Akshay1595/Lithium-ion_battery_as_service/Docs/Bills/Bill_30.jpeg

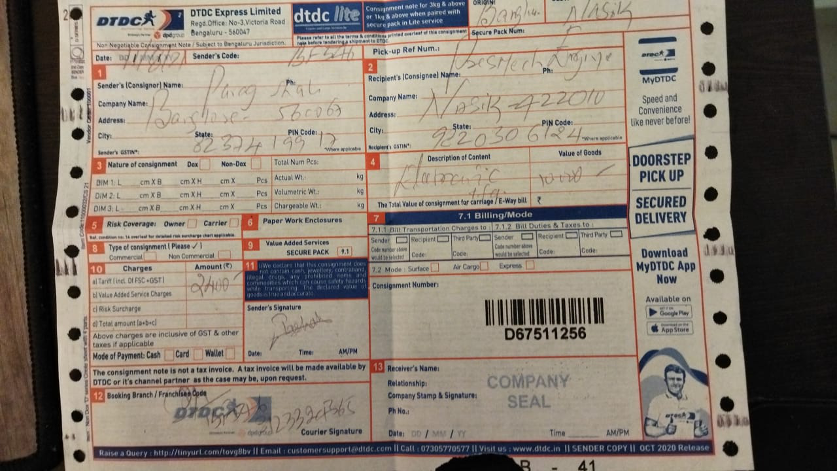
Docs/Bills/Bill_30.jpeg
