Akshay1595/Lithium-ion_battery_as_service/Docs/Technical docs/LiBaaS Embedded System Block Diagram.pptx

## LiBaaS Embedded System Block Diagram

Date: 09-12-2020

## Embedded System

Embedded System

LCD

Battery pack

CAN
Tranceiver

BMS

uC Development board

Contactor

Contactor
Control

Keypad

Power Supply

Power Jack

## Wiring diagram V1.0

Keep open wire

Re+

Re-

Relay

Keep open wire

BMS

CANH

CANL

Battery pack

Fuse

Connectors

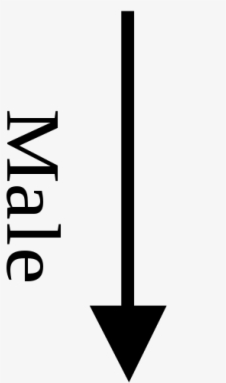
[picture p13: figure]
Female Connector Symbol - Free Transparent PNG Download - PNGkey
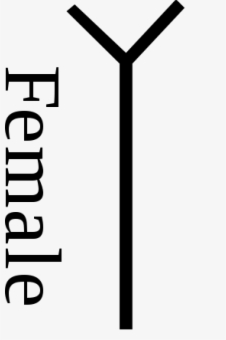
[picture p14: figure]
Female Connector Symbol - Free Transparent PNG Download - PNGkey

Charger

Keep open wire

Keep open wire

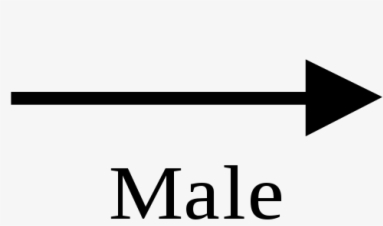
[picture p15: figure]
Female Connector Symbol - Free Transparent PNG Download - PNGkey
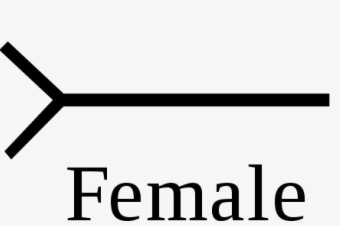
[picture p16: figure]
Female Connector Symbol - Free Transparent PNG Download - PNGkey

## Slide 4
