Akshay1595/Lithium-ion_battery_as_service/Docs/Technical docs/LiBaaS Embedded System_Load Box for batterypack.pptx

## LiBaaS Embedded System Load

Date: 08-03-2021

## Load Diagram

12V 1A

12V 1A

12V 1A

12V 1A

Battery
pack

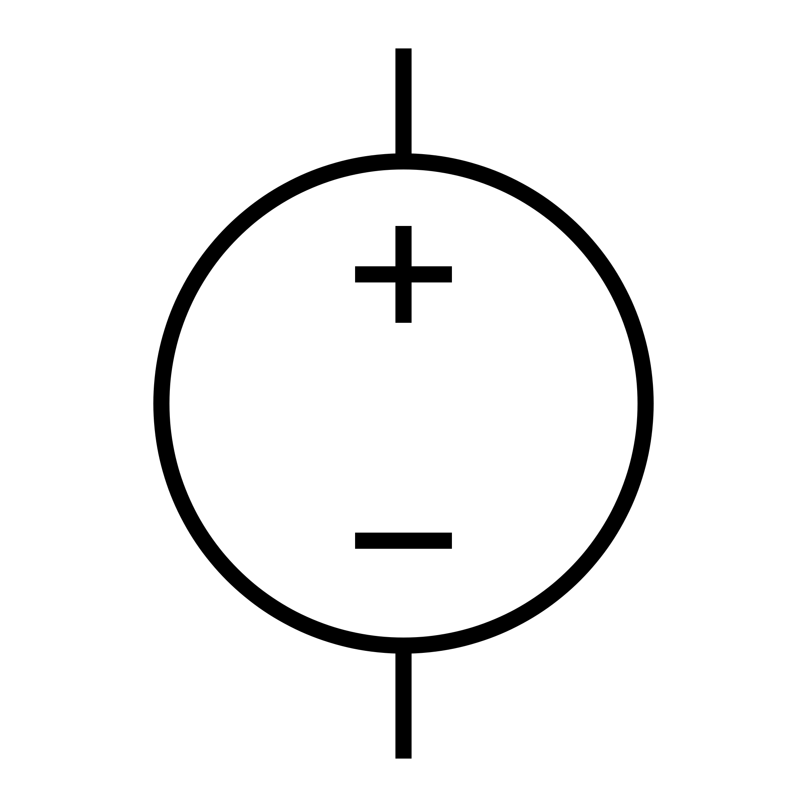
[picture p17: figure]
