Akshay1595/Lithium-ion_battery_as_service/Docs/Bills/Bill_18.PDF

PackageID: 1Z5674320407168464 ShipmentID: 5674324MTJ3

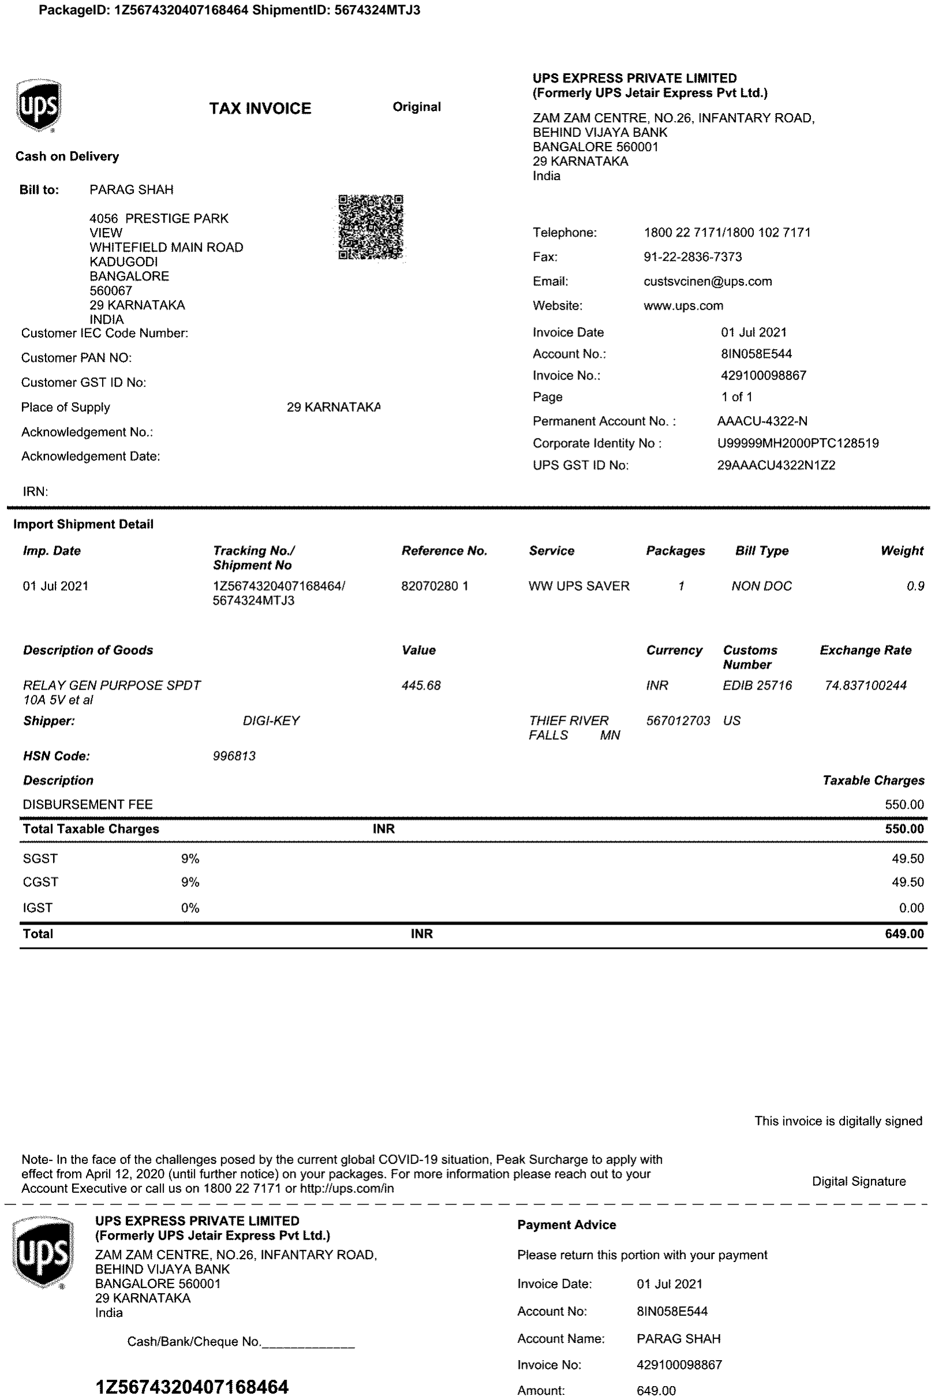
[picture p27: page 3]
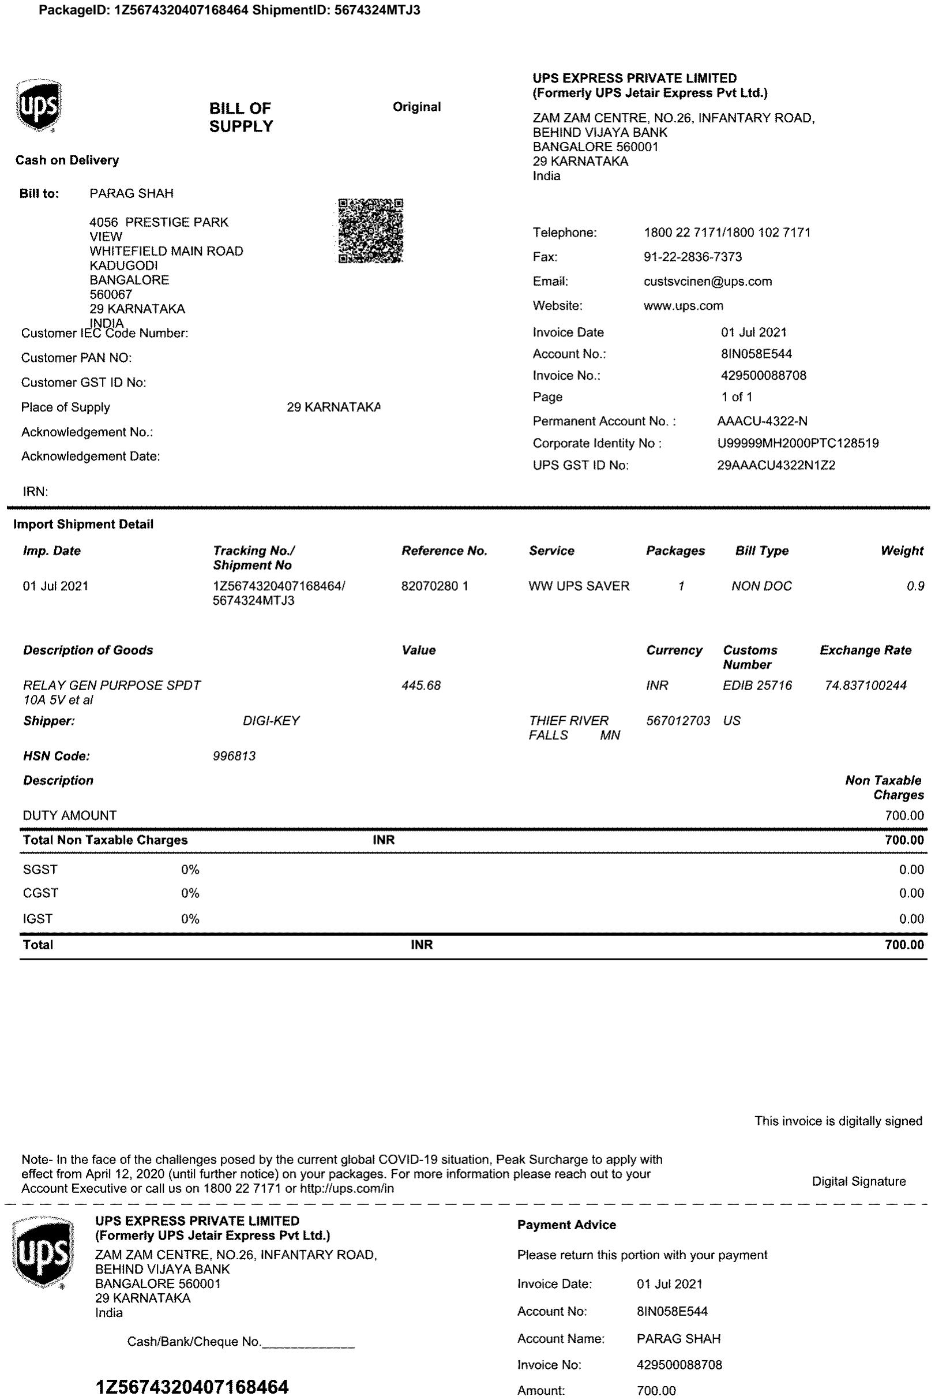
[picture p28: page 4]
