Akshay1595/Lithium-ion_battery_as_service/HW_design/Libaas_System/LibaaS calculations.xlsx

Vin | 53 | V
Vout | 15 | V
Vdrop | 38 | V
Iload | 0.05 | A
Pd (BJT) | 1.9 | W
R6 | 5 | OHM
Pd (R6) | 0.0125 | W
IZ | 0.005 | A
Vz | 15 | V
R8 | 7600 | OHM
Pd (R8) | 0.19 | W
