Akshay1595/Lithium-ion_battery_as_service/Docs/Bills/Bill_13.PNG

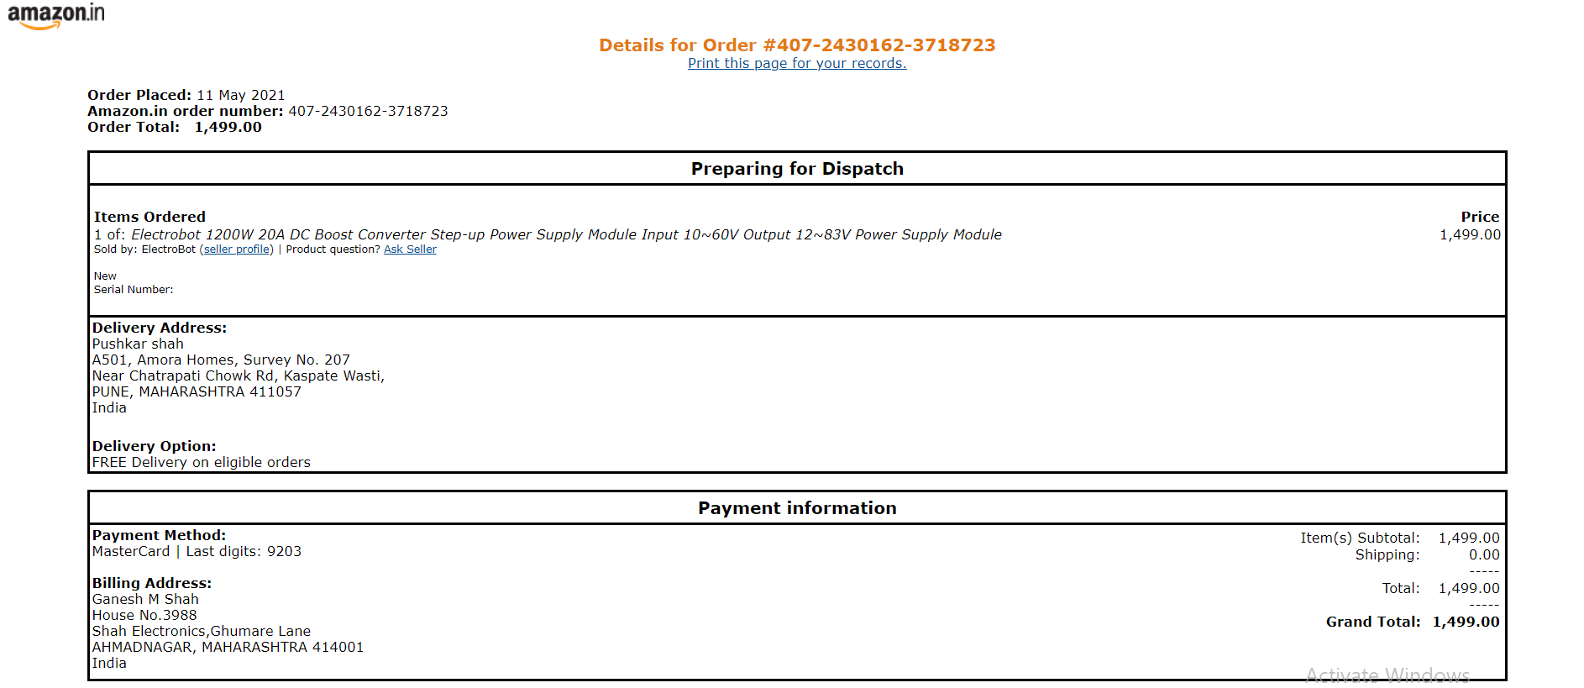
Docs/Bills/Bill_13.PNG
