Akshay1595/Lithium-ion_battery_as_service/Docs/Bills/Bill_27.jpeg

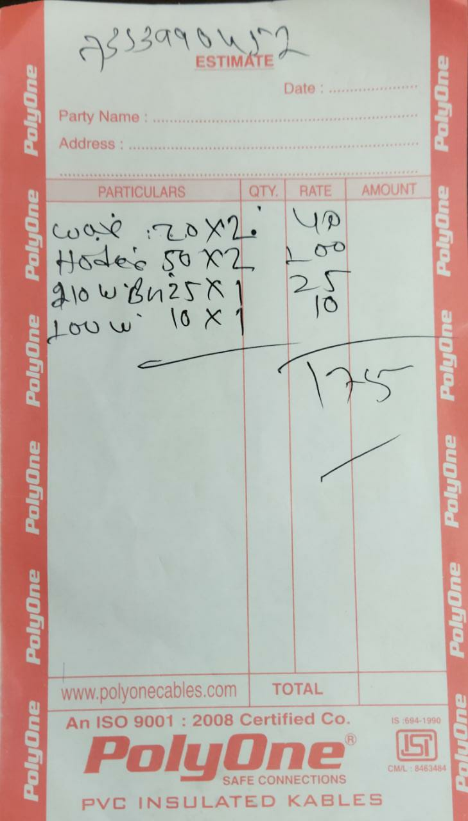
Docs/Bills/Bill_27.jpeg
