Akshay1595/Lithium-ion_battery_as_service/Docs/Bills/Bill_32.JPG

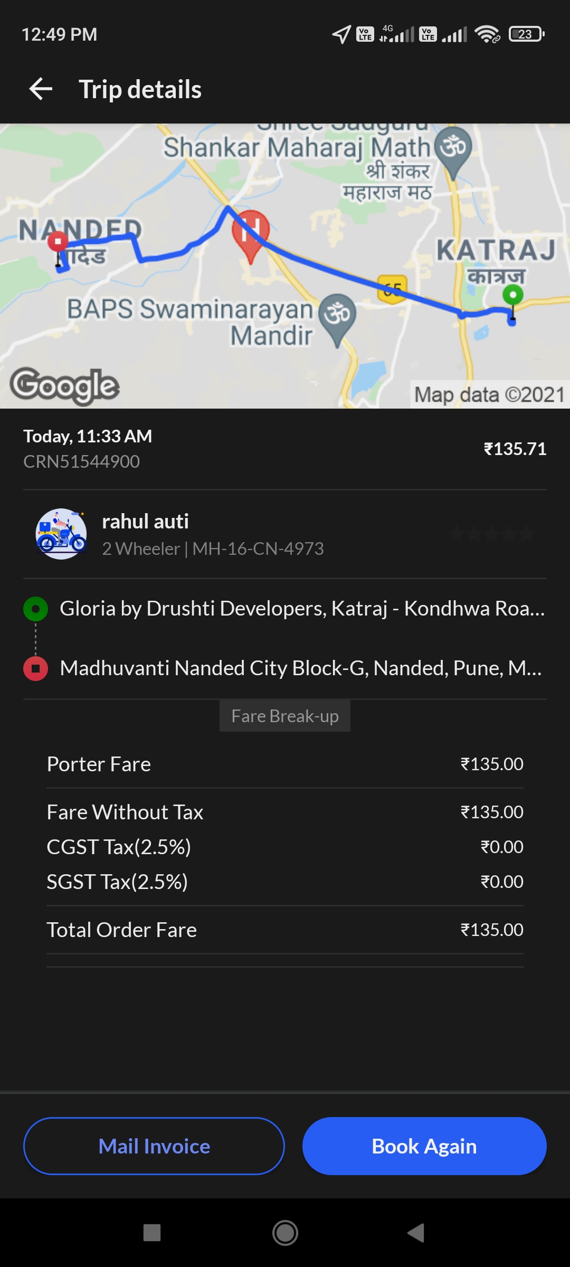
Docs/Bills/Bill_32.JPG
