Akshay1595/Lithium-ion_battery_as_service/Docs/Bills/Bill_33.jpeg

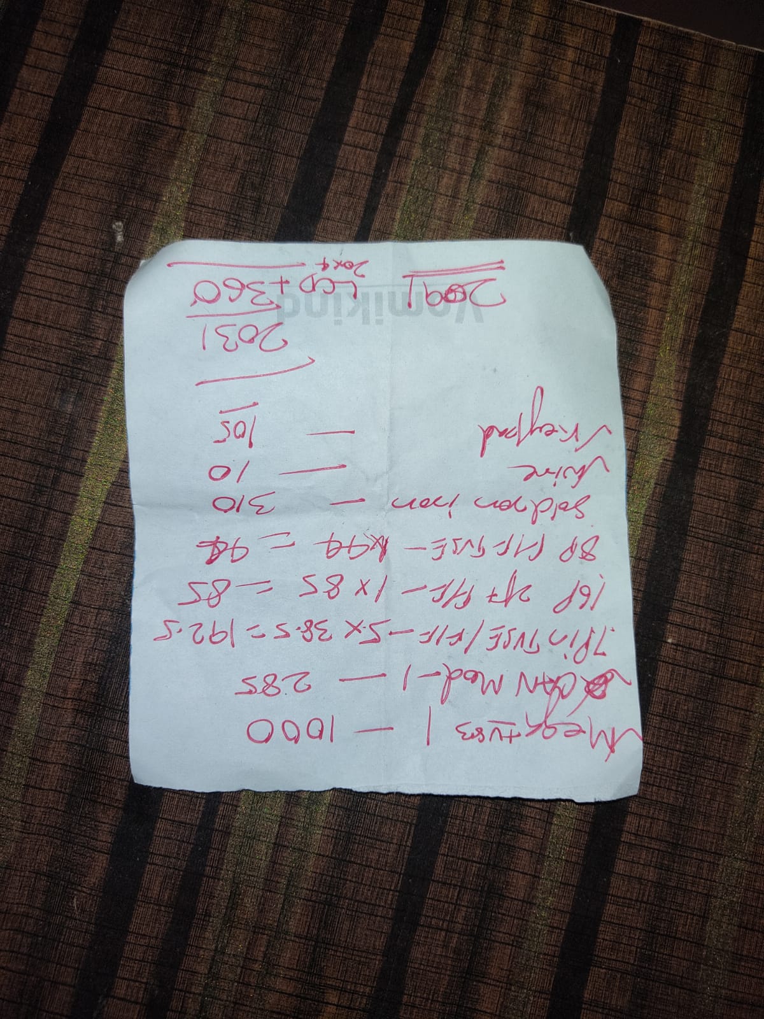
Docs/Bills/Bill_33.jpeg
