Akshay1595/Lithium-ion_battery_as_service/Docs/FlowChart.png

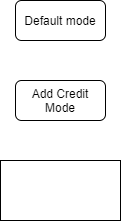
Docs/FlowChart.png
