Akshay1595/Lithium-ion_battery_as_service/Docs/megapins.png

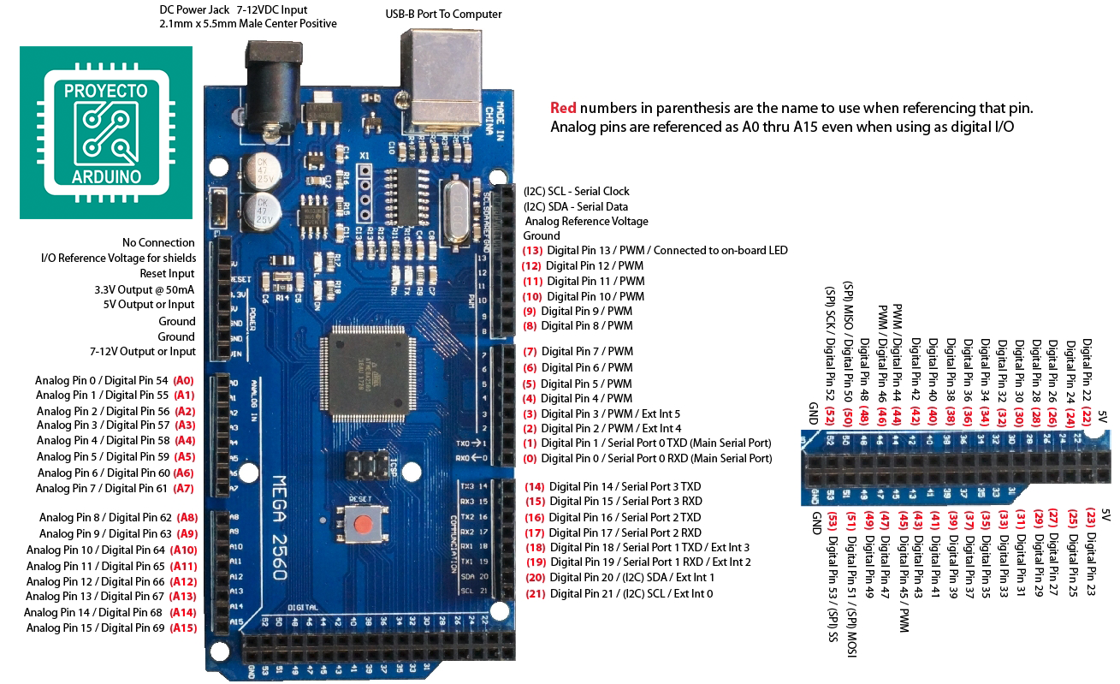
Docs/megapins.png
