Akshay1595/Lithium-ion_battery_as_service/HW_design/Libaas_System/LiBaaS_component assy check.xlsx

Sheet: BOARD1
DESIGNATOR | DESC | Part no. | Footprint | STATUS
C1 | CAP CER 1uF 25V 10% X7R 0805 |  | CAP0805 | OKAY
C2 | CAP CER 0.1uF 50V 5% X7R 0805, CAP CER 0.1uF 100V 10% X7R 0805 |  | CAP0805 | OKAY
C3 | CAP ALUM 47uF 63V 20% SMD |  | CAPAE-D10_H1050 | MOUNTED WRONG | OKAY
C4 | CAP CER 0.1uF 50V 5% X7R 0805, CAP CER 0.1uF 100V 10% X7R 0805 |  | CAP0805 | OKAY
C5 | CAP CER 0.1uF 50V 5% X7R 0805, CAP CER 0.1uF 100V 10% X7R 0805 |  | CAP0805 | OKAY
C6 | Aluminium Electrolytic Capacitors - Radial Leaded 470uF 10 Volts 20% |  | UVZ1A471MED | OKAY
C7 | CAP CER 0.1uF 50V 5% X7R 0805, CAP CER 0.1uF 100V 10% X7R 0805 |  | CAP0805 | OKAY
C8 | CAP CER 0.1uF 50V 5% X7R 0805, CAP CER 0.1uF 100V 10% X7R 0805 |  | CAP0805 | OKAY
C9 | CAP CER 0.1uF 50V 5% X7R 0805, CAP CER 0.1uF 100V 10% X7R 0805 |  | CAP0805 | OKAY
C10 | CAP CER 1uF 25V 10% X7R 0805 |  | CAP0805 | OKAY
C11 | CAP CER 1uF 25V 10% X7R 0805 |  | CAP0805 | OKAY
C12 | CAP CER 0.1uF 50V 5% X7R 0805, CAP CER 0.1uF 100V 10% X7R 0805 |  | CAP0805 | OKAY
C13 | CAP CER 0.1uF 50V 5% X7R 0805, CAP CER 0.1uF 100V 10% X7R 0805 |  | CAP0805 | OKAY
C14 | CAP CER 1uF 25V 10% X7R 0805 |  | CAP0805 | OKAY
C15 | CAP CER 0.1uF 50V 5% X7R 0805, CAP CER 0.1uF 100V 10% X7R 0805 |  | CAP0805 | OKAY
C16 | CAP CER 1uF 25V 10% X7R 0805 |  | CAP0805 | OKAY
D1 | DIODE GEN 1000V 1A DO214AC | S1M | DO-214AC | OKAY
D2 | LED YELLOW CLEAR 0805 |  | LED0805 | NOT OKAY
D3 | Zener Diodes 7.5V 500mW SOD123 | MMSZ5236B-7-F | SOD-123 | MOUNTED WRONG | OKAY
D4 | Zener Diode 36V 225mW Â±6% Surface Mount SOT-23-3 (TO-236) | BZX84C36-7 | SOT23 | REMOVE | OKAY
D5 | DIODE SCHOTTKY 60V 1A MICROSMP | B140HW-7-F | SOD123 | OKAY
D6 | TH Zener diode_36V |  | DO-41 | TO BE MOUNTED | OKAY
D7 | DIODE GEN 75V 150mA SOD-323 | 1N4148WSQ-7-F | SOD-323 | OKAY
D8 | DIODE GEN 75V 150mA SOD-323 | 1N4148WSQ-7-F | SOD-323 | OKAY
D9 | LED BLUE CLEAR 0805 |  | LED0805 | MOUNTED WRONG | OKAY
D10 | LED RED CLEAR 0805 |  | LED0805 | MOUNTED WRONG | OKAY
D11 | LED WHITE CLEAR 0805 |  | LED0805 | MOUNTED WRONG | no
D12 | LED GREEN CLEAR 0805 |  | LED0805 | MOUNTED WRONG | OKAY
D13 | LED RED CLEAR 0805 |  | LED0805 | MOUNTED WRONG | OKAY
D14 | Zener Diodes 15V 590mW SOD123 | BZT52-B15X | SOD-123 | OKAY
J1, J2 | PHOENIX CONNECTOR 5.08mm PITCH |  |  | OKAY
L1 | 100uH 1.05A 20% SMD Power Inductors; shielded | SDS125-101M-LF |  | OKAY
Q1 | BJT NPN 100V 3A TO-252 | MJD31CT4-A | TO-252 | OKAY
Q2 | BJT NPN 25V 3A SOT-223 | BCP56 | SOT-223 | OKAY
Q3 | FET N-CH 60V 380mA SOT23 | 2N7002KQ-7 | SOT-23 | OKAY
R1 | RES THK FLM 10Ohm 1% 1/2W 2512 |  | RES2512 | OKAY
R2 | RES THK FLM 0Ohm 1% 1/4W 1206 |  | RES1206 | OKAY
R3 | RES THK FLM 0Ohm 1% 1/4W 1206 |  | RES1206 | OKAY
R4 | RES THK FLM 2.2kOhm 1% 1/10W 0603 |  | RES0603 | OKAY
R5 | RES THK FLM 182Ohm 1% 1/10W 0603 |  | RES0603 | OKAY
R6 | RES THK FLM 10Ohm 1% 1/2W 2512 |  | RES2512 | OKAY
R7 | RES THK FLM 0Ohm 1% 1/4W 1206 |  | RES1206 | OKAY
R8 | RES THK FLM 2.2kOhm 1% 1/10W 0603 |  | RES0603 | OKAY
R9 | RES THK FLM 2.2kOhm 1% 1/10W 0603 |  | RES0603 | OKAY
R10 | RES THK FLM 47kOhm 1% 1/10W 0603 |  | RES0603 | OKAY
R11 | RES THK FLM 182Ohm 1% 1/10W 0603 |  | RES0603 | OKAY
R12 | RES THK FLM 182Ohm 1% 1/10W 0603 |  | RES0603 | OKAY
R13 | RES THK FLM 182Ohm 1% 1/10W 0603 |  | RES0603 | OKAY
R14 | RES THK FLM 182Ohm 1% 1/10W 0603 |  | RES0603 | OKAY
R15 | Through Hole Trimmer Potentiometer_10K |  | Trim_pot_3296 | OKAY
R16 | RES THK FLM 182Ohm 1% 1/10W 0603 |  | RES0603 | OKAY
R17 | RES THK FLM 182Ohm 1% 1/10W 0603 |  | RES0603 | OKAY
SW1 | SW TACT SPST-NO 32V 10mA GULLWING |  | KSC243GLFG | OKAY
U1 | Switching Voltage Regulators 3A Step-Down SMPS Regulator |  | LM2596-5.0 | OKAY
U2 | Arduino Mega |  | Berg strips | OKAY

Sheet: BOARD2
DESIGNATOR | DESC | Part no. | Footprint | STATUS
C1 | CAP CER 1uF 25V 10% X7R 0805 |  | CAP0805 | OKAY
C2 | CAP CER 0.1uF 50V 5% X7R 0805, CAP CER 0.1uF 100V 10% X7R 0805 |  | CAP0805 | OKAY
C3 | CAP ALUM 47uF 63V 20% SMD |  | CAPAE-D10_H1050 | MOUNTED WRONG | OKAY
C4 | CAP CER 0.1uF 50V 5% X7R 0805, CAP CER 0.1uF 100V 10% X7R 0805 |  | CAP0805 | OKAY
C5 | CAP CER 0.1uF 50V 5% X7R 0805, CAP CER 0.1uF 100V 10% X7R 0805 |  | CAP0805 | OKAY
C6 | Aluminium Electrolytic Capacitors - Radial Leaded 470uF 10 Volts 20% |  | UVZ1A471MED | TO BE MOUNTED | OKAY
C7 | CAP CER 0.1uF 50V 5% X7R 0805, CAP CER 0.1uF 100V 10% X7R 0805 |  | CAP0805 | OKAY
C8 | CAP CER 0.1uF 50V 5% X7R 0805, CAP CER 0.1uF 100V 10% X7R 0805 |  | CAP0805 | OKAY
C9 | CAP CER 0.1uF 50V 5% X7R 0805, CAP CER 0.1uF 100V 10% X7R 0805 |  | CAP0805 | OKAY
C10 | CAP CER 1uF 25V 10% X7R 0805 |  | CAP0805 | OKAY
C11 | CAP CER 1uF 25V 10% X7R 0805 |  | CAP0805 | OKAY
C12 | CAP CER 0.1uF 50V 5% X7R 0805, CAP CER 0.1uF 100V 10% X7R 0805 |  | CAP0805 | OKAY
C13 | CAP CER 0.1uF 50V 5% X7R 0805, CAP CER 0.1uF 100V 10% X7R 0805 |  | CAP0805 | OKAY
C14 | CAP CER 1uF 25V 10% X7R 0805 |  | CAP0805 | OKAY
C15 | CAP CER 0.1uF 50V 5% X7R 0805, CAP CER 0.1uF 100V 10% X7R 0805 |  | CAP0805 | OKAY
C16 | CAP CER 1uF 25V 10% X7R 0805 |  | CAP0805 | OKAY
D1 | DIODE GEN 1000V 1A DO214AC | S1M | DO-214AC | OKAY
D2 | LED YELLOW CLEAR 0805 |  | LED0805 | NOT OKAY
D3 | Zener Diodes 7.5V 500mW SOD123 | MMSZ5236B-7-F | SOD-123 | MOUNTED WRONG | OKAY
D4 | Zener Diode 36V 225mW Â±6% Surface Mount SOT-23-3 (TO-236) | BZX84C36-7 | SOT23 | REMOVE | OKAY
D5 | DIODE SCHOTTKY 60V 1A MICROSMP | B140HW-7-F | SOD123 | OKAY
D6 | TH Zener diode_36V |  | DO-41 | TO BE MOUNTED | OKAY
D7 | DIODE GEN 75V 150mA SOD-323 | 1N4148WSQ-7-F | SOD-323 | OKAY
D8 | DIODE GEN 75V 150mA SOD-323 | 1N4148WSQ-7-F | SOD-323 | OKAY
D9 | LED BLUE CLEAR 0805 |  | LED0805 | MOUNTED WRONG | OKAY
D10 | LED RED CLEAR 0805 |  | LED0805 | MOUNTED WRONG | OKAY
D11 | LED WHITE CLEAR 0805 |  | LED0805 | MOUNTED WRONG | OKAY
D12 | LED GREEN CLEAR 0805 |  | LED0805 | MOUNTED WRONG | OKAY
D13 | LED RED CLEAR 0805 |  | LED0805 | MOUNTED WRONG | OKAY
D14 | Zener Diodes 15V 590mW SOD123 | BZT52-B15X | SOD-123 | TO BE MOUNTED | OKAY
J1, J2 | PHOENIX CONNECTOR 5.08mm PITCH |  |  | OKAY
L1 | 100uH 1.05A 20% SMD Power Inductors; shielded | SDS125-101M-LF |  | TO BE MOUNTED | OKAY
Q1 | BJT NPN 100V 3A TO-252 | MJD31CT4-A | TO-252 | OKAY
Q2 | BJT NPN 25V 3A SOT-223 | BCP56 | SOT-223 | OKAY
Q3 | FET N-CH 60V 380mA SOT23 | 2N7002KQ-7 | SOT-23 | OKAY
R1 | RES THK FLM 10Ohm 1% 1/2W 2512 |  | RES2512 | ADJUST IN THE PITCH | OKAY
R2 | RES THK FLM 0Ohm 1% 1/4W 1206 |  | RES1206 | OKAY
R3 | RES THK FLM 0Ohm 1% 1/4W 1206 |  | RES1206 | OKAY
R4 | RES THK FLM 2.2kOhm 1% 1/10W 0603 |  | RES0603 | TO BE MOUNTED | OKAY
R5 | RES THK FLM 182Ohm 1% 1/10W 0603 |  | RES0603 | OKAY
R6 | RES THK FLM 10Ohm 1% 1/2W 2512 |  | RES2512 | OKAY
R7 | RES THK FLM 0Ohm 1% 1/4W 1206 |  | RES1206 | OKAY
R8 | RES THK FLM 2.2kOhm 1% 1/10W 0603 |  | RES0603 | TO BE MOUNTED | OKAY
R9 | RES THK FLM 2.2kOhm 1% 1/10W 0603 |  | RES0603 | OKAY
R10 | RES THK FLM 47kOhm 1% 1/10W 0603 |  | RES0603 | OKAY
R11 | RES THK FLM 182Ohm 1% 1/10W 0603 |  | RES0603 | OKAY
R12 | RES THK FLM 182Ohm 1% 1/10W 0603 |  | RES0603 | OKAY
R13 | RES THK FLM 182Ohm 1% 1/10W 0603 |  | RES0603 | OKAY
R14 | RES THK FLM 182Ohm 1% 1/10W 0603 |  | RES0603 | OKAY
R15 | Through Hole Trimmer Potentiometer_10K |  | Trim_pot_3296 | OKAY
R16 | RES THK FLM 182Ohm 1% 1/10W 0603 |  | RES0603 | OKAY
R17 | RES THK FLM 182Ohm 1% 1/10W 0603 |  | RES0603 | OKAY
SW1 | SW TACT SPST-NO 32V 10mA GULLWING |  | KSC243GLFG | OKAY
U1 | Switching Voltage Regulators 3A Step-Down SMPS Regulator |  | LM2596-5.0 | OKAY
U2 | Arduino Mega |  | Berg strips | TO BE MOUNTED | OKAY
DS1 |  |  | Berg strips | TO BE MOUNTED | OKAY
P2 |  |  | Berg strips | TO BE MOUNTED | OKAY

Sheet: BOARD3
DESIGNATOR | DESC | Part no. | Footprint | STATUS
C1 | CAP CER 1uF 25V 10% X7R 0805 |  | CAP0805 | OKAY
C2 | CAP CER 0.1uF 50V 5% X7R 0805, CAP CER 0.1uF 100V 10% X7R 0805 |  | CAP0805 | OKAY
C3 | CAP ALUM 47uF 63V 20% SMD |  | CAPAE-D10_H1050 | MOUNTED WRONG | OKAY
C4 | CAP CER 0.1uF 50V 5% X7R 0805, CAP CER 0.1uF 100V 10% X7R 0805 |  | CAP0805 | OKAY
C5 | CAP CER 0.1uF 50V 5% X7R 0805, CAP CER 0.1uF 100V 10% X7R 0805 |  | CAP0805 | OKAY
C6 | Aluminium Electrolytic Capacitors - Radial Leaded 470uF 10 Volts 20% |  | UVZ1A471MED | TO BE MOUNTED | OKAY
C7 | CAP CER 0.1uF 50V 5% X7R 0805, CAP CER 0.1uF 100V 10% X7R 0805 |  | CAP0805 | OKAY
C8 | CAP CER 0.1uF 50V 5% X7R 0805, CAP CER 0.1uF 100V 10% X7R 0805 |  | CAP0805 | OKAY
C9 | CAP CER 0.1uF 50V 5% X7R 0805, CAP CER 0.1uF 100V 10% X7R 0805 |  | CAP0805 | OKAY
C10 | CAP CER 1uF 25V 10% X7R 0805 |  | CAP0805 | OKAY
C11 | CAP CER 1uF 25V 10% X7R 0805 |  | CAP0805 | OKAY
C12 | CAP CER 0.1uF 50V 5% X7R 0805, CAP CER 0.1uF 100V 10% X7R 0805 |  | CAP0805 | OKAY
C13 | CAP CER 0.1uF 50V 5% X7R 0805, CAP CER 0.1uF 100V 10% X7R 0805 |  | CAP0805 | OKAY
C14 | CAP CER 1uF 25V 10% X7R 0805 |  | CAP0805 | OKAY
C15 | CAP CER 0.1uF 50V 5% X7R 0805, CAP CER 0.1uF 100V 10% X7R 0805 |  | CAP0805 | OKAY
C16 | CAP CER 1uF 25V 10% X7R 0805 |  | CAP0805 | OKAY
D1 | DIODE GEN 1000V 1A DO214AC | S1M | DO-214AC | OKAY
D2 | LED YELLOW CLEAR 0805 |  | LED0805 | NOT OKAY
D3 | Zener Diodes 7.5V 500mW SOD123 | MMSZ5236B-7-F | SOD-123 | MOUNTED WRONG | OKAY
D4 | Zener Diode 36V 225mW Â±6% Surface Mount SOT-23-3 (TO-236) | BZX84C36-7 | SOT23 | REMOVE | OKAY
D5 | DIODE SCHOTTKY 60V 1A MICROSMP | B140HW-7-F | SOD123 | OKAY
D6 | TH Zener diode_36V |  | DO-41 | TO BE MOUNTED | OKAY
D7 | DIODE GEN 75V 150mA SOD-323 | 1N4148WSQ-7-F | SOD-323 | OKAY
D8 | DIODE GEN 75V 150mA SOD-323 | 1N4148WSQ-7-F | SOD-323 | OKAY
D9 | LED BLUE CLEAR 0805 |  | LED0805 | MOUNTED WRONG | OKAY
D10 | LED RED CLEAR 0805 |  | LED0805 | MOUNTED WRONG | OKAY
D11 | LED WHITE CLEAR 0805 |  | LED0805 | MOUNTED WRONG | OKAY
D12 | LED GREEN CLEAR 0805 |  | LED0805 | MOUNTED WRONG | OKAY
D13 | LED RED CLEAR 0805 |  | LED0805 | MOUNTED WRONG | OKAY
D14 | Zener Diodes 15V 590mW SOD123 | BZT52-B15X | SOD-123 | TO BE MOUNTED | OKAY
J1, J2 | PHOENIX CONNECTOR 5.08mm PITCH |  |  | OKAY
L1 | 100uH 1.05A 20% SMD Power Inductors; shielded | SDS125-101M-LF |  | TO BE MOUNTED | OKAY
Q1 | BJT NPN 100V 3A TO-252 | MJD31CT4-A | TO-252 | OKAY
Q2 | BJT NPN 25V 3A SOT-223 | BCP56 | SOT-223 | OKAY
Q3 | FET N-CH 60V 380mA SOT23 | 2N7002KQ-7 | SOT-23 | OKAY
R1 | RES THK FLM 10Ohm 1% 1/2W 2512 |  | RES2512 | ADJUST IN THE PITCH | OKAY
R2 | RES THK FLM 0Ohm 1% 1/4W 1206 |  | RES1206 | OKAY
R3 | RES THK FLM 0Ohm 1% 1/4W 1206 |  | RES1206 | OKAY
R4 | RES THK FLM 2.2kOhm 1% 1/10W 0603 |  | RES0603 | TO BE MOUNTED | OKAY
R5 | RES THK FLM 182Ohm 1% 1/10W 0603 |  | RES0603 | OKAY
R6 | RES THK FLM 10Ohm 1% 1/2W 2512 |  | RES2512 | OKAY
R7 | RES THK FLM 0Ohm 1% 1/4W 1206 |  | RES1206 | OKAY
R8 | RES THK FLM 2.2kOhm 1% 1/10W 0603 |  | RES0603 | TO BE MOUNTED | OKAY
R9 | RES THK FLM 2.2kOhm 1% 1/10W 0603 |  | RES0603 | OKAY
R10 | RES THK FLM 47kOhm 1% 1/10W 0603 |  | RES0603 | OKAY
R11 | RES THK FLM 182Ohm 1% 1/10W 0603 |  | RES0603 | OKAY
R12 | RES THK FLM 182Ohm 1% 1/10W 0603 |  | RES0603 | OKAY
R13 | RES THK FLM 182Ohm 1% 1/10W 0603 |  | RES0603 | OKAY
R14 | RES THK FLM 182Ohm 1% 1/10W 0603 |  | RES0603 | OKAY
R15 | Through Hole Trimmer Potentiometer_10K |  | Trim_pot_3296 | OKAY
R16 | RES THK FLM 182Ohm 1% 1/10W 0603 |  | RES0603 | OKAY
R17 | RES THK FLM 182Ohm 1% 1/10W 0603 |  | RES0603 | OKAY
SW1 | SW TACT SPST-NO 32V 10mA GULLWING |  | KSC243GLFG | OKAY
U1 | Switching Voltage Regulators 3A Step-Down SMPS Regulator |  | LM2596-5.0 | OKAY
U2 | Arduino Mega |  | Berg strips | OKAY

Sheet: BOARD4
DESIGNATOR | DESC | Part no. | Footprint | STATUS
C1 | CAP CER 1uF 25V 10% X7R 0805 |  | CAP0805 | OKAY
C2 | CAP CER 0.1uF 50V 5% X7R 0805, CAP CER 0.1uF 100V 10% X7R 0805 |  | CAP0805 | OKAY
C3 | CAP ALUM 47uF 63V 20% SMD |  | CAPAE-D10_H1050 | MOUNTED WRONG | OKAY
C4 | CAP CER 0.1uF 50V 5% X7R 0805, CAP CER 0.1uF 100V 10% X7R 0805 |  | CAP0805 | OKAY
C5 | CAP CER 0.1uF 50V 5% X7R 0805, CAP CER 0.1uF 100V 10% X7R 0805 |  | CAP0805 | OKAY
C6 | Aluminium Electrolytic Capacitors - Radial Leaded 470uF 10 Volts 20% |  | UVZ1A471MED | TO BE MOUNTED | OKAY
C7 | CAP CER 0.1uF 50V 5% X7R 0805, CAP CER 0.1uF 100V 10% X7R 0805 |  | CAP0805 | OKAY
C8 | CAP CER 0.1uF 50V 5% X7R 0805, CAP CER 0.1uF 100V 10% X7R 0805 |  | CAP0805 | OKAY
C9 | CAP CER 0.1uF 50V 5% X7R 0805, CAP CER 0.1uF 100V 10% X7R 0805 |  | CAP0805 | OKAY
C10 | CAP CER 1uF 25V 10% X7R 0805 |  | CAP0805 | OKAY
C11 | CAP CER 1uF 25V 10% X7R 0805 |  | CAP0805 | OKAY
C12 | CAP CER 0.1uF 50V 5% X7R 0805, CAP CER 0.1uF 100V 10% X7R 0805 |  | CAP0805 | OKAY
C13 | CAP CER 0.1uF 50V 5% X7R 0805, CAP CER 0.1uF 100V 10% X7R 0805 |  | CAP0805 | OKAY
C14 | CAP CER 1uF 25V 10% X7R 0805 |  | CAP0805 | OKAY
C15 | CAP CER 0.1uF 50V 5% X7R 0805, CAP CER 0.1uF 100V 10% X7R 0805 |  | CAP0805 | OKAY
C16 | CAP CER 1uF 25V 10% X7R 0805 |  | CAP0805 | OKAY
D1 | DIODE GEN 1000V 1A DO214AC | S1M | DO-214AC | OKAY
D2 | LED YELLOW CLEAR 0805 |  | LED0805 | NOT OKAY
D3 | Zener Diodes 7.5V 500mW SOD123 | MMSZ5236B-7-F | SOD-123 | MOUNTED WRONG | OKAY
D4 | Zener Diode 36V 225mW Â±6% Surface Mount SOT-23-3 (TO-236) | BZX84C36-7 | SOT23 | REMOVE | OKAY
D5 | DIODE SCHOTTKY 60V 1A MICROSMP | B140HW-7-F | SOD123 | OKAY
D6 | TH Zener diode_36V |  | DO-41 | TO BE MOUNTED | OKAY
D7 | DIODE GEN 75V 150mA SOD-323 | 1N4148WSQ-7-F | SOD-323 | OKAY
D8 | DIODE GEN 75V 150mA SOD-323 | 1N4148WSQ-7-F | SOD-323 | OKAY
D9 | LED BLUE CLEAR 0805 |  | LED0805 | MOUNTED WRONG | OKAY
D10 | LED RED CLEAR 0805 |  | LED0805 | MOUNTED WRONG | OKAY
D11 | LED WHITE CLEAR 0805 |  | LED0805 | MOUNTED WRONG | OKAY
D12 | LED GREEN CLEAR 0805 |  | LED0805 | MOUNTED WRONG | OKAY
D13 | LED RED CLEAR 0805 |  | LED0805 | MOUNTED WRONG | OKAY
D14 | Zener Diodes 15V 590mW SOD123 | BZT52-B15X | SOD-123 | TO BE MOUNTED | OKAY
J1, J2 | PHOENIX CONNECTOR 5.08mm PITCH |  |  | OKAY
L1 | 100uH 1.05A 20% SMD Power Inductors; shielded | SDS125-101M-LF |  | TO BE MOUNTED | OKAY
Q1 | BJT NPN 100V 3A TO-252 | MJD31CT4-A | TO-252 | OKAY
Q2 | BJT NPN 25V 3A SOT-223 | BCP56 | SOT-223 | OKAY
Q3 | FET N-CH 60V 380mA SOT23 | 2N7002KQ-7 | SOT-23 | OKAY
R1 | RES THK FLM 10Ohm 1% 1/2W 2512 |  | RES2512 | ADJUST IN THE PITCH | OKAY
R2 | RES THK FLM 0Ohm 1% 1/4W 1206 |  | RES1206 | OKAY
R3 | RES THK FLM 0Ohm 1% 1/4W 1206 |  | RES1206 | OKAY
R4 | RES THK FLM 2.2kOhm 1% 1/10W 0603 |  | RES0603 | TO BE MOUNTED | OKAY
R5 | RES THK FLM 182Ohm 1% 1/10W 0603 |  | RES0603 | OKAY
R6 | RES THK FLM 10Ohm 1% 1/2W 2512 |  | RES2512 | OKAY
R7 | RES THK FLM 0Ohm 1% 1/4W 1206 |  | RES1206 | OKAY
R8 | RES THK FLM 2.2kOhm 1% 1/10W 0603 |  | RES0603 | TO BE MOUNTED | OKAY
R9 | RES THK FLM 2.2kOhm 1% 1/10W 0603 |  | RES0603 | OKAY
R10 | RES THK FLM 47kOhm 1% 1/10W 0603 |  | RES0603 | OKAY
R11 | RES THK FLM 182Ohm 1% 1/10W 0603 |  | RES0603 | OKAY
R12 | RES THK FLM 182Ohm 1% 1/10W 0603 |  | RES0603 | OKAY
R13 | RES THK FLM 182Ohm 1% 1/10W 0603 |  | RES0603 | OKAY
R14 | RES THK FLM 182Ohm 1% 1/10W 0603 |  | RES0603 | OKAY
R15 | Through Hole Trimmer Potentiometer_10K |  | Trim_pot_3296 | OKAY
R16 | RES THK FLM 182Ohm 1% 1/10W 0603 |  | RES0603 | OKAY
R17 | RES THK FLM 182Ohm 1% 1/10W 0603 |  | RES0603 | OKAY
SW1 | SW TACT SPST-NO 32V 10mA GULLWING |  | KSC243GLFG | OKAY
U1 | Switching Voltage Regulators 3A Step-Down SMPS Regulator |  | LM2596-5.0 | OKAY
U2 | Arduino Mega |  | Berg strips | TO BE MOUNTED | ok

Sheet: BOARD5
DESIGNATOR | DESC | Part no. | Footprint | STATUS
C1 | CAP CER 1uF 25V 10% X7R 0805 |  | CAP0805 | OKAY
C2 | CAP CER 0.1uF 50V 5% X7R 0805, CAP CER 0.1uF 100V 10% X7R 0805 |  | CAP0805 | OKAY
C3 | CAP ALUM 47uF 63V 20% SMD |  | CAPAE-D10_H1050 | MOUNTED WRONG | OKAY
C4 | CAP CER 0.1uF 50V 5% X7R 0805, CAP CER 0.1uF 100V 10% X7R 0805 |  | CAP0805 | OKAY
C5 | CAP CER 0.1uF 50V 5% X7R 0805, CAP CER 0.1uF 100V 10% X7R 0805 |  | CAP0805 | OKAY
C6 | Aluminium Electrolytic Capacitors - Radial Leaded 470uF 10 Volts 20% |  | UVZ1A471MED | TO BE MOUNTED | OKAY
C7 | CAP CER 0.1uF 50V 5% X7R 0805, CAP CER 0.1uF 100V 10% X7R 0805 |  | CAP0805 | OKAY
C8 | CAP CER 0.1uF 50V 5% X7R 0805, CAP CER 0.1uF 100V 10% X7R 0805 |  | CAP0805 | OKAY
C9 | CAP CER 0.1uF 50V 5% X7R 0805, CAP CER 0.1uF 100V 10% X7R 0805 |  | CAP0805 | OKAY
C10 | CAP CER 1uF 25V 10% X7R 0805 |  | CAP0805 | OKAY
C11 | CAP CER 1uF 25V 10% X7R 0805 |  | CAP0805 | OKAY
C12 | CAP CER 0.1uF 50V 5% X7R 0805, CAP CER 0.1uF 100V 10% X7R 0805 |  | CAP0805 | OKAY
C13 | CAP CER 0.1uF 50V 5% X7R 0805, CAP CER 0.1uF 100V 10% X7R 0805 |  | CAP0805 | OKAY
C14 | CAP CER 1uF 25V 10% X7R 0805 |  | CAP0805 | OKAY
C15 | CAP CER 0.1uF 50V 5% X7R 0805, CAP CER 0.1uF 100V 10% X7R 0805 |  | CAP0805 | OKAY
C16 | CAP CER 1uF 25V 10% X7R 0805 |  | CAP0805 | OKAY
D1 | DIODE GEN 1000V 1A DO214AC | S1M | DO-214AC | OKAY
D2 | LED YELLOW CLEAR 0805 |  | LED0805 | NOT OKAY | OKAY
D3 | Zener Diodes 7.5V 500mW SOD123 | MMSZ5236B-7-F | SOD-123 | MOUNTED WRONG | OKAY
D4 | Zener Diode 36V 225mW Â±6% Surface Mount SOT-23-3 (TO-236) | BZX84C36-7 | SOT23 | REMOVE | OKAY
D5 | DIODE SCHOTTKY 60V 1A MICROSMP | B140HW-7-F | SOD123 | OKAY
D6 | TH Zener diode_36V |  | DO-41 | TO BE MOUNTED | OKAY
D7 | DIODE GEN 75V 150mA SOD-323 | 1N4148WSQ-7-F | SOD-323 | OKAY
D8 | DIODE GEN 75V 150mA SOD-323 | 1N4148WSQ-7-F | SOD-323 | OKAY
D9 | LED BLUE CLEAR 0805 |  | LED0805 | MOUNTED WRONG | OKAY
D10 | LED RED CLEAR 0805 |  | LED0805 | MOUNTED WRONG | OKAY
D11 | LED WHITE CLEAR 0805 |  | LED0805 | MOUNTED WRONG | OKAY
D12 | LED GREEN CLEAR 0805 |  | LED0805 | MOUNTED WRONG | OKAY
D13 | LED RED CLEAR 0805 |  | LED0805 | MOUNTED WRONG | MOUNTED WRONG
D14 | Zener Diodes 15V 590mW SOD123 | BZT52-B15X | SOD-123 | TO BE MOUNTED | OKAY
J1, J2 | PHOENIX CONNECTOR 5.08mm PITCH |  |  | OKAY
L1 | 100uH 1.05A 20% SMD Power Inductors; shielded | SDS125-101M-LF |  | TO BE MOUNTED | OKAY
Q1 | BJT NPN 100V 3A TO-252 | MJD31CT4-A | TO-252 | OKAY
Q2 | BJT NPN 25V 3A SOT-223 | BCP56 | SOT-223 | OKAY
Q3 | FET N-CH 60V 380mA SOT23 | 2N7002KQ-7 | SOT-23 | OKAY
R1 | RES THK FLM 10Ohm 1% 1/2W 2512 |  | RES2512 | ADJUST IN THE PITCH | to be mounted again
R2 | RES THK FLM 0Ohm 1% 1/4W 1206 |  | RES1206 | OKAY
R3 | RES THK FLM 0Ohm 1% 1/4W 1206 |  | RES1206 | OKAY
R4 | RES THK FLM 2.2kOhm 1% 1/10W 0603 |  | RES0603 | TO BE MOUNTED | OKAY
R5 | RES THK FLM 182Ohm 1% 1/10W 0603 |  | RES0603 | OKAY
R6 | RES THK FLM 10Ohm 1% 1/2W 2512 |  | RES2512 | OKAY
R7 | RES THK FLM 0Ohm 1% 1/4W 1206 |  | RES1206 | OKAY
R8 | RES THK FLM 2.2kOhm 1% 1/10W 0603 |  | RES0603 | TO BE MOUNTED | OKAY
R9 | RES THK FLM 2.2kOhm 1% 1/10W 0603 |  | RES0603 | OKAY
R10 | RES THK FLM 47kOhm 1% 1/10W 0603 |  | RES0603 | OKAY
R11 | RES THK FLM 182Ohm 1% 1/10W 0603 |  | RES0603 | OKAY
R12 | RES THK FLM 182Ohm 1% 1/10W 0603 |  | RES0603 | OKAY
R13 | RES THK FLM 182Ohm 1% 1/10W 0603 |  | RES0603 | OKAY
R14 | RES THK FLM 182Ohm 1% 1/10W 0603 |  | RES0603 | OKAY
R15 | Through Hole Trimmer Potentiometer_10K |  | Trim_pot_3296 | OKAY
R16 | RES THK FLM 182Ohm 1% 1/10W 0603 |  | RES0603 | OKAY
R17 | RES THK FLM 182Ohm 1% 1/10W 0603 |  | RES0603 | OKAY
SW1 | SW TACT SPST-NO 32V 10mA GULLWING |  | KSC243GLFG | OKAY
U1 | Switching Voltage Regulators 3A Step-Down SMPS Regulator |  | LM2596-5.0 | OKAY
U2 | Arduino Mega |  | Berg strips | TO BE MOUNTED | OKAY
DS1 |  |  | Berg strips | TO BE MOUNTED | OKAY
