Akshay1595/Lithium-ion_battery_as_service/HW_design/Libaas_System/Libaas_System_090221.xlsx

Description | Designator | Footprint | Part number | Quantity
CAP CER 1uF 25V 10% X7R 0805 | C1, C10, C11, C14, C16 | CAP0805 | C0805C105K3RACAUTO | 5
CAP CER 0.1uF 50V 5% X7R 0805, CAP CER 0.1uF 100V 10% X7R 0805 | C2, C4, C5, C7, C8, C9, C12, C13, C15 | CAP0805 | C0805C104J5RACAUTO, C0805C104K1RACAUTO | 9
CAP ALUM 47uF 63V 20% SMD | C3 | CAPAE-D10_H1050 | EEE-TG1J470P | 1
Aluminium Electrolytic Capacitors - Radial Leaded 470uF 10 Volts 20% | C6 | UVZ1A471MED | UVZ1A471MED | 1
DIODE GEN 1000V 1A DO214AC | D1 | DO-214AC | S1M | 1
LED YELLOW CLEAR 0805 | D2 | LED0805 | LTST-C171CKT | 1
Zener Diodes 7.5V 500mW SOD123 | D3 | SOD-123 | MMSZ5236B-7-F | 1
Zener Diode 36V 225mW Â±6% Surface Mount SOT-23-3 (TO-236) | D4 | SOT23 | BZX84C36-7 | 1
DIODE SCHOTTKY 60V 1A MICROSMP | D5 | SOD123 | B140HW-7-F | 1
TH Zener diode_36V_Do not populate | D6 | DO-41 | Diode 1N4007 | 1
DIODE GEN 75V 150mA SOD-323 | D7, D8 | SOD-323 | 1N4148WSQ-7-F | 2
LED BLUE CLEAR 0805 | D9 | LED0805 | LTST-C171CKT | 1
LED RED CLEAR 0805 | D10, D13 | LED0805 | LTST-C171CKT | 2
LED WHITE CLEAR 0805 | D11 | LED0805 | LTST-C171CKT | 1
LED GREEN CLEAR 0805 | D12 | LED0805 | LTST-C171CKT | 1
Zener Diodes 15V 590mW SOD123 | D14 | SOD-123 | BZT52-B15X | 1
Relimate 16 pin connector | DS1 | LCD_20X4B | LCD_20X4B | 1
PHOENIX CONNECTOR 5.08mm PITCH | J1, J2 | 1711725 | 1711725 | 2
100uH 1.05A 20% SMD Power Inductors; shielded | L1 | SDS125-101M-LF | SDS125-101M-LF | 1
Header, 8-Pin, Relimate connector | P1 | HDR1X8 | Header 8 | 1
Berg strips_7 header | P2 | HDR1X7 | Header 7 | 1
BJT NPN 100V 3A TO-252 | Q1 | TO-252 | MJD31CT4-A | 1
BJT NPN 25V 3A SOT-223 | Q2 | SOT-223 | BCP56 | 1
FET N-CH 60V 380mA SOT23 | Q3 | SOT-23 | 2N7002KQ-7 | 1
RES THK FLM 10Ohm 1% 1/2W 2512 | R1, R6 | RES2512 | CRCW121010R0FKEA | 2
RES THK FLM 0Ohm 1% 1/4W 1206 | R2, R3, R7 | RES1206 | CRCW12060000Z0EA | 3
RES 4.7K OHM 0.1% 1/8W 0603 | R4, R8 | RES0603 | TNPW06034K70BEEA | 2
RES THK FLM 182Ohm 1% 1/10W 0603 | R5, R11, R12, R13, R14, R16, R17 | RES0603 | CRCW0603182RFKEA | 7
RES THK FLM 2.2kOhm 1% 1/10W 0603 | R9 | RES0603 | CRCW06032K20FKEA | 1
RES THK FLM 47kOhm 1% 1/10W 0603 | R10 | RES0603 | CRCW060347K0FKEA | 1
Through Hole Trimmer Potentiometer_10K | R15 | Trim_pot_3296 | Trim_pot_3296 | 1
SW TACT SPST-NO 32V 10mA GULLWING | SW1 | KSC2XXG | KSC243GLFG | 1
Switching Voltage Regulators 3A Step-Down SMPS Regulator | U1 | LM2596-5.0 | LM2596-5.0 | 1
Arduino Mega | U2 | Berg strips | Berg strips | 1
