Akshay1595/Lithium-ion_battery_as_service/HW_design/Libaas_System/Libaas_System.xlsx

Comment | Description | Designator | Footprint | LibRef | Quantity | Remarks
1uF | CAP CER 1uF 25V 10% X7R 0805 | C1, C10, C11, C14 | CAP0805 | C0805C105K3RACAUTO | 4 | Leaded will also work if SMD not available
0.1uF | CAP CER 0.1uF 50V 5% X7R 0805, CAP CER 0.1uF 100V 10% X7R 0805 | C2, C4, C5, C7, C8, C9, C12, C13, C15 | CAP0805 | C0805C104J5RACAUTO, C0805C104K1RACAUTO | 9 | Leaded will also work if SMD not available
47uF | CAP ALUM 47uF 63V 20% SMD | C3 | CAPAE-D10_H1050 | EEE-TG1J470P | 1 | Leaded will also work if SMD not available
470uF | Aluminium Electrolytic Capacitors - Radial Leaded 470uF 10 Volts 20% | C6 | UVZ1A471MED | UVZ1A471MED | 1 | Leaded will also work if SMD not available
DIODE_CA | DIODE GEN 1000V 1A DO214AC | D1 | DO-214AC | S1M | 1 | 1N4007 / 1N4004
LED | LED YELLOW CLEAR 0805 | D2 | LED0801 |  | 1
LED | LED BLUE CLEAR 0805 | D9 | LED0802 |  | 1
LED | LED GREEN CLEAR 0805 | D10 | LED0803 |  | 1
LED | LED WHITE CLEAR 0805 | D11 | LED0804 |  | 1
LED | LED RED CLEAR 0805 | D12 | LED0805 |  | 1
MMSZ5236B-7-F | Zener Diodes 7.5V 500mW SOD123 | D3 | SOD-123 | MMSZ5236B-7-F | 1 | 1N5236B / Leaded will also work if SMD not available
BZT52C36-HE3-18 | DIODE ZENER 36V 8mA SOD-123 | D4 | SOD-123 | BZT52C36-HE3-18 | 1 | TZX36C-TAP / 1N5258B-TR / Leaded will also work if SMD not available
SCHOTTKY_CA | DIODE SCHOTTKY 60V 1A MICROSMP | D5 | DO-219AD | V1P6HM3/H | 1
SZMM3Z15VT1G | DIODE ZENER 15V 10mA 300mW 5% SOD323 | D6 | SOD-123 | SZMM3Z15VT1G | 1 | Leaded will also work if SMD not available
DIODE_CA | DIODE GEN 75V 150mA SOD-323 | D7, D8 | SOD-323 | 1N4148WSQ-7-F | 2 | 1N4148 / Leaded will also work if SMD not available
1711725 | PHOENIX CONNECTOR 5.08mm PITCH | J1, J2 | 1711725 | 1711725 | 3
IND | Fixed Inductors 1000uH 10% SMD 1280 | L1 | SRR1280-102K | SRR1280-102K | 1 | ANY 1mH 800mA inductor
KEYPAD | Header, 8-Pin | P1 | HDR1X8 | Header 8 | 1
NPN_BCE | BJT NPN 100V 3A TO-252 | Q1 | TO-252 | MJD31CT4-A | 1 | FDD6N25TM / MJD31C / NJD2873 / Any Dpak 3A 100V NPN transistor
BCP56 | BJT NPN 25V 3A SOT-223 | Q2 | SOT-223 | BCP56 | 1
NMOS_GSD | FET N-CH 60V 380mA SOT23 | Q3 | SOT-23 | 2N7002KQ-7 | 1
10 | RES THK FLM 10Ohm 1% 1/2W 1210 | R1, R6 | RES1210 | CRCW121010R0FKEA | 2
0 | RES THK FLM 0Ohm 1% 1/4W 1206 | R2, R3, R7 | RES1206 | CRCW12060000Z0EA | 3
4.7k | RES 4.7K OHM 0.1% 1/8W 0603 | R4, R8 | RES0603 | TNPW06034K70BEEA | 2 | Leaded will also work if SMD not available
182 | RES THK FLM 182Ohm 1% 1/10W 0603 | R5, R11, R12, R13, R14 | RES0603 | CRCW0603182RFKEA | 5 | Leaded will also work if SMD not available
2.2k | RES THK FLM 2.2kOhm 1% 1/10W 0603 | R9 | RES0603 | CRCW06032K20FKEA | 1 | Leaded will also work if SMD not available
47K | RES THK FLM 47kOhm 1% 1/10W 0603 | R10 | RES0603 | CRCW060347K0FKEA | 1 | Leaded will also work if SMD not available
Trim_pot_3296 | Through Hole Trimmer Potentiometer | R15 | Trim_pot_3296 | Trim_pot_3296 | 1 | 5K
Arduino Mega | Arduino Mega | U | Arduino Mega | Arduino Mega Rev 3 | 1
LM2576-5.0 | Switching Voltage Regulators 3A Step-Down SMPS Regulator | U1 | LM2576-5.0 | LM2576-5.0 | 1
