Akshay1595/Lithium-ion_battery_as_service/HW_design/Libaas_System/Libaas_System_1.xlsx

Comment | Description | Designator | Footprint | LibRef | Quantity_purchase | EACH RATE | Rajiv total | Mouser part n | Mouser rate | Mouser Total
1uF | CAP CER 1uF 25V 10% X7R 0805 | C1, C10, C11, C14 | CAP0805 | C0805C105K3RACAUTO | 50 | 1.2 | 60 |  | 50
0.1uF | CAP CER 0.1uF 50V 5% X7R 0805, CAP CER 0.1uF 100V 10% X7R 0805 | C2, C4, C5, C7, C8, C9, C12, C13, C15 | CAP0805 | C0805C104J5RACAUTO, C0805C104K1RACAUTO | 100 | 0.65 | 65 | CL21B104KCFSFNE | 1.95 | 195
47uF | CAP ALUM 47uF 50V 20% SMD | C3 | SMD | ELNA | 20 | 3 | 60 |  |  | 0
470uF | Aluminium Electrolytic Capacitors - Radial Leaded 470uF 10 Volts 20% | C6 | UVZ1A471MED | UVZ1A471MED | 10 | 2.5 | 25 |  |  | 0
DIODE_CA | DIODE GEN 1000V 1A DO214AC | D1 | DO-214AC | S1M | 20 | 2.5 | 50 |  |  | 0
LED | LED YELLOW CLEAR 0805 | D2 | LED0801 |  | 20 | 0.8 | 16 |  |  | 0
LED | LED BLUE CLEAR 0805 | D9 | LED0802 |  | 20 | 1 | 20 |  |  | 0
LED | LED GREEN CLEAR 0805 | D10 | LED0803 |  | 20 | 0.8 | 16 |  |  | 0
LED | LED WHITE CLEAR 0805 | D11 | LED0804 |  | 20 | 1 | 20 |  |  | 0
LED | LED RED CLEAR 0805 | D12 | LED0805 |  | 20 | 0.8 | 16 |  |  | 0
MMSZ5236B-7-F | Zener Diodes 7.5V 500mW SOD123 | D3 | SOD-123 | MMSZ5236B-7-F / Suggest nearby Value for same specifications | 20 | 3 | 60 |  | 9.27 | 185.4
BZT52C36-HE3-18 | 36V Zener TH Hole | D4 | Home buy |  | 20 |  | 0 |  | 13.8 | 276
SCHOTTKY_CA | DIODE SCHOTTKY 60V 1A MICROSMP | D5 | DO-219AD | V1P6HM3/H | 20 |  | 0 |  | 18.4 | 368
BZT52-B15X | DIODE ZENER 15V 10mA 300mW 5% SOD323 | D6 | SOD-123 | BZT52-B15X or SZMM3Z15VT1G | 20 | 3 | 60 |  | 11.46 | 229.2
DIODE_CA | DIODE GEN 75V 150mA SOD-323 | D7, D8 | SOD-323 | 1N4148WSQ-7-F | 20 | 3 | 60 |  | 10.51 | 210.2
LCD_20X4B | 20 x 4 LCD | DS1 | LCD_20X4B | LCD_20X4B | 1 |  | 0 |  |  | 0
1711725 | PHOENIX CONNECTOR 5.08mm PITCH | J1, J2 | 1711725 | 1711725 | 25 | 8 | 200 |  |  | 0
IND | Fixed Inductors 1000uH 10% SMD 1280 | L1 | SRR1280-102K | SRR1280-102K | 10 |  | 0 |  | 65.92 | 659.2
KEYPAD | Header, 8-Pin | P1 | Bergstrips | Header 8 | 1 |  | 0 |  |  | 0
NPN_BCE | BJT NPN 100V 3A TO-252 | Q1 | TO-252 | MJD31CT4-A | 10 | 25 | 250 |  | 53.35 | 533.5
BCP56 | BJT NPN 25V 3A SOT-223 | Q2 | SOT-223 | BCP56 | 20 | 7 | 140 |  |  | 0
NMOS_GSD | FET N-CH 60V 380mA SOT23 | Q3 | SOT-23 | 2N7002KQ-7 | 20 | 2 | 40 |  |  | 0
10 | RES THK FLM 10Ohm 1% 1/2W 1210 | R1, R6 | RES1210 | CRCW121010R0FKEA | 40 | 1.5 | 60 | RK73B2ETTD100J | 9.27 | 370.8
0 | RES THK FLM 0Ohm 1% 1/4W 1206 | R2, R3, R7 | RES1206 | CRCW12060000Z0EA | 50 | 0.3 | 15 |  |  | 0
4.7k | RES 4.7K OHM 0.1% 1/8W 0603 | R4, R8 | RES0603 | TNPW06034K70BEEA | 50 |  | 0 | CRCW06034K70JNEBC | 2.19 | 109.5
180 | RES THK FLM 180Ohm 1% 1/10W 0603 | R5, R11, R12, R13, R14 | RES0603 | CRCW0603182RFKEA | 50 | 0.2 | 10 | RK73B1JTTDD181J | 0.73 | 36.5
2.2k | RES THK FLM 2.2kOhm 1% 1/10W 0603 | R9 | RES0603 | CRCW06032K20FKEA | 60 | 0.25 | 15 |  |  | 0
47K | RES THK FLM 47kOhm 1% 1/10W 0603 | R10 | RES0603 | CRCW060347K0FKEA | 60 | 0.25 | 15 |  |  | 0
Trim_pot_3296 | Through Hole Trimmer Potentiometer | R15 | Trim_pot_3296 | Trim_pot_3296 | 12 | 6.25 | 75 |  |  | 0
Arduino Mega | Arduino Mega | U | Arduino Mega | Arduino Mega Rev 3 | 1 | 750 | 750 |  |  | 0
LM2576-5.0 | Switching Voltage Regulators 3A Step-Down SMPS Regulator | U1 | LM2576-5.0 | LM2576-5.0 | 10 | 30 | 300 |  |  | 0
KSC2-SPST-NO | SW TACT SPST-NO 32V 10mA GULLWING | SW1 | KSC2XXG | KSC243GLFG | 20 |  |  |  | 47.89 | 957.8
 |  |  |  |  |  |  | 2398 |  |  | 4131.1
