Akshay1595/Lithium-ion_battery_as_service/Docs/Expenses Details.xlsx

Sheet: Expenses_proto1
Sr. No | Date | Details | Bill No. | Amount | Paid by | Bill Link | Petrol Expenses |  | Individual | Total Expenses
1 | 2020-09-14 | ACS 712 Current Sensor LED Jumper Wire 5K POT | 1 | 295 | Akshay | Bill_1 (https://github.com/Akshay1595/Lithium-ion_battery_as_service/blob/master/Docs/Bills/Bill_1.JPG) | 100 |  | Akshay | 14245
2 | 2020-12-04 | 16x2 LCD Jumper Wire 5K POT 4x4 Keypad | 2 | 337 | Akshay | Bill_2 (https://github.com/Akshay1595/Lithium-ion_battery_as_service/blob/master/Docs/Bills/Bill_2.JPG) | 100 |  | Parag | 16457
3 | 2021-01-13 | 20x4 LCD Arduino MEGA 2560 Burgstrip | 3 | 1302 | Akshay | Bill_3 (https://github.com/Akshay1595/Lithium-ion_battery_as_service/blob/master/Docs/Bills/Bill_3.JPG) | 100
4 | 2021-01-20 | 2 MCP2525 CAN module 9-PIN D connectors for CAN burgstrips male and female 5K pot Single strend wire | 4 | 744 | Parag | Bill_4 (https://github.com/Akshay1595/Lithium-ion_battery_as_service/blob/master/Docs/Bills/Bill_4.JPG) | 100
5 | 2021-01-22 | 20x4 Blue LCD 1 burgstrip male 1K pot | 5 | 429 | Akshay | Bill_5 (https://github.com/Akshay1595/Lithium-ion_battery_as_service/blob/master/Docs/Bills/Bill_5.JPG) | 100
6 |  | CAN Analyzer | 6 | 0 | 0 |  | 0
7 |  | Battery Pack and BMS | 7 | 0 | Soby | Invoice (https://github.com/Akshay1595/Lithium-ion_battery_as_service/blob/master/Docs/Proforma%20Invoice-Parag%20Shah%2002.02.2021.pdf) | 0 | 29653
8 |  | 5 sets of PCBs |  | 5000 | Akshay |  | 0
9 | 2021-02-22 | 16 types of components from Rajiv | 9 | 2098 | Akshay | Bill_9 | 100
10 | 2021-02-27 | 16 types of components from Comkey | 10 | 2434 | Parag | Bill_10 | 0
11 | 2021-04-02 | Burgstrips | 11 | 94 | Akshay | Bill_11 (https://github.com/Akshay1595/Lithium-ion_battery_as_service/blob/master/Docs/Bills/Bill_11.JPG) | 100
12 | 2021-04-26 | DMM | 12 | 268 | Parag | Bill_12
13 | 2021-05-11 | Boost converter | 13 | 1500 | Parag | Bill_13
14 | 2021-03-26 | Courier | 14 | 310 | Parag | Bill_14
16 | 2021-06-21 | Battery pack delivery | 15 | 93 | Akshay | Bill_15 (https://github.com/Akshay1595/Lithium-ion_battery_as_service/blob/master/Docs/Bills/Bill_15.jpeg)
17 | 2021-06-27 | Charger Delivery from SSK home (Petrol 50Rs) + 4 bulbs for load experiment (15W 15 Rs each) |  | 110 | Akshay
18 | 2021-07-12 | Rajiv Electronics Bill | 16 | 1105 | Akshay | Bill_16 (https://github.com/Akshay1595/Lithium-ion_battery_as_service/blob/master/Docs/Bills/Bill_16.jpeg)
19 | 2021-07-13 | Bus Ticket Bill and Auto travel | 17 | 2205 | Akshay | Bill_17 (https://github.com/Akshay1595/Lithium-ion_battery_as_service/blob/master/Docs/Bills/Bill_17.jpeg) | 500 | (Auto500)
20 | 2021-06-28 | relays | 18 | 2994 | Parag | Bill_18 (https://github.com/Akshay1595/Lithium-ion_battery_as_service/blob/master/Docs/Bills/Bill_18.PDF)
21 | 2021-07-07 | hardware tools | 19 | 550 | Parag | Bill_19 (https://github.com/Akshay1595/Lithium-ion_battery_as_service/blob/master/Docs/Bills/Bill_19.jpeg)
22 | 2021-05-07 | PCB assembly | 20 | 2500 | Parag | Bill_20 (https://github.com/Akshay1595/Lithium-ion_battery_as_service/blob/master/Docs/Bills/Bill_20.jpeg)
23 | 2021-07-15 | cab | 21 | 282 | Akshay | Bill_21 (https://github.com/Akshay1595/Lithium-ion_battery_as_service/blob/master/Docs/Bills/Bill_21.pdf)
24 | 2021-08-04 | cab | 22 | 246 | Parag | Bill_22 (https://github.com/Akshay1595/Lithium-ion_battery_as_service/blob/master/Docs/Bills/Bill_22.pdf)
25 | 2021-08-04 | cab | 23 | 266 | Parag | Bill_23 (https://github.com/Akshay1595/Lithium-ion_battery_as_service/blob/master/Docs/Bills/Bill_23.pdf)
26 | 2021-07-15 | cab | 24 | 336 | Akshay | Bill_24 (https://github.com/Akshay1595/Lithium-ion_battery_as_service/blob/master/Docs/Bills/Bill_24.pdf)
27 | 2021-07-15 | hardware tools | 25 | 384 | Akshay | Bill_25 (https://github.com/Akshay1595/Lithium-ion_battery_as_service/blob/master/Docs/Bills/Bill_25.jpeg)
28 | 2021-08-04 | acrylic box | 26 | 1800 | Parag | Bill_26 (https://github.com/Akshay1595/Lithium-ion_battery_as_service/blob/master/Docs/Bills/Bill_26.jpeg)
29 | 2021-07-15 | hardware tools | 27 | 175 | Akshay | Bill_27 (https://github.com/Akshay1595/Lithium-ion_battery_as_service/blob/master/Docs/Bills/Bill_27.jpeg)
30 | 2021-07-15 | cable | 28 | 70 | Parag | Bill_28 (https://github.com/Akshay1595/Lithium-ion_battery_as_service/blob/master/Docs/Bills/Bill_28.jpeg)
31 | 2021-07-15 | hardware components | 29 | 375 | Parag | Bill_29 (https://github.com/Akshay1595/Lithium-ion_battery_as_service/blob/master/Docs/Bills/Bill_29.jpeg)
32 | 2021-08-11 | courier LiBaas 1st unit | 30 | 2400 | Parag | Bill_30 (https://github.com/Akshay1595/Lithium-ion_battery_as_service/blob/master/Docs/Bills/Bill_29.jpeg) | 100
 |  | Total |  | 30702 |  |  | 1300
 |  | Total Petrol + Expenses |  | 32002
 |  | Received |  | 15000 |  | Balance | -17002

Sheet: Expenses_proto2
Sr. No | Date | Details | Bill No. | Amount | Paid by Parag | Paid by Akshay | Bill Link | Paid by | Petrol Expenses | Individual | Total Expenses
1 | 2021-08-12 | Courier Load Box | 31 | 500 | 0 | 500 | Bill_31 (https://github.com/Akshay1595/Lithium-ion_battery_as_service/blob/master/Docs/Bills/Bill_31.jpeg) | Own Pocket |  | Akshay | 636
2 | 2021-11-24 | Courier Battery pack to Nikhil | 32 | 136 | 0 | 136 | Bill_32 (https://github.com/Akshay1595/Lithium-ion_battery_as_service/blob/master/Docs/Bills/Bill_32.JPG) | Own Pocket |  | Parag | 6790
3 | 2021-12-02 | Equipments purchased before Date of Deployment | 33 | 2390 | 2390 | 0 | Bill_33 (https://github.com/Akshay1595/Lithium-ion_battery_as_service/blob/master/Docs/Bills/Bill_33.jpeg) | Through 10K
4 | 2021-12-03 | Petrol for Nashik Travel | 34 | 3400 | 3400 | 0 | Bill_34 (https://github.com/Akshay1595/Lithium-ion_battery_as_service/blob/master/Docs/Bills/Bill_34.jpeg) | Through 10K
5 | 2021-10-07 | Battery Repairing Cost | 35 | 1000 | 1000 | 0 | Bill_35 (https://github.com/Akshay1595/Lithium-ion_battery_as_service/blob/master/Docs/Bills/Bill_35.jpeg) | Through 10K
6 |  |  |  |  |  |  | Bill_
7 |  |  |  |  |  |  | Bill_
8 |  |  |  |  |  |  | Bill_
9 |  |  |  |  |  |  | Bill_
10 |  |  |  |  |  |  | Bill_
11 |  |  |  |  |  |  | Bill_
12 |  |  |  |  |  |  | Bill_
13 |  |  |  |  |  |  | Bill_
14 |  |  |  |  |  |  | Bill_
16 |  |  |  |  |  |  | Bill_
17 |  |  |  |  |  |  | Bill_
18 |  |  |  |  |  |  | Bill_
19 |  |  |  |  |  |  | Bill_
20 |  |  |  |  |  |  | Bill_
21 |  |  |  |  |  |  | Bill_
22 |  |  |  |  |  |  | Bill_
23 |  |  |  |  |  |  | Bill_
24 |  |  |  |  |  |  | Bill_
25 |  |  |  |  |  |  | Bill_
26 |  |  |  |  |  |  | Bill_
27 |  |  |  |  |  |  | Bill_
28 |  |  |  |  |  |  | Bill_
29 |  |  |  |  |  |  | Bill_
30 |  |  |  |  |  |  | Bill_
31 |  |  |  |  |  |  | Bill_
32 |  |  |  |  |  |  | Bill_
33 |  |  |  |  |  |  | Bill_
 |  | Total |  | 7426 | 6790 | 636 |  |  | 0
 |  | Total Petrol + Expenses |  | 7426
 |  | Received |  | 10000 |  |  | Balance |  | 2574

Sheet: Internal
Sr No. | Amount | From Individual | To Idividual | Date | Remark
1 | 20000 | Sobby | Parag | 2021-01-18 | Paid as a kick start amount
2 | 5000 | Sobby | Parag | 2021-01-18 | Paid Procurement Charges for initial components and testing
3 | 20000 | Parag | Akshay | 2021-01-21 | Paid as a share of Engineering Cost
4 | 10000 | Sobby | Parag | 2021-02-10 | Paid Procurement Charges for components and PCB
5 | 10000 | Parag | Akshay | 2021-02-10 | Paid Procurement Charges for components and PCB internally
6 | 36000 | Sobby | Parag | 2021-08-30 | Paid for 1st milestones
7 | 17002 | Sobby | Parag | 2021-08-30 | Paid the reimbursement for 1st proto
8 | 4245 | Parag | Akshay | 2021-08-30 | Paid the reimbursement for 1st proto (Akshay Share)
9 | 10000 | Sobby | Parag | 2021-11-23 | Paid Procurement Charges for 2nd components and PCB
10 | 31100 | Sobby | Parag | 2021-02-14 | Paid for 2nd milestone partial
