Akshay1595/Lithium-ion_battery_as_service/HW_design/WBDesign9.pdf

## WEBENCH ® Design Report

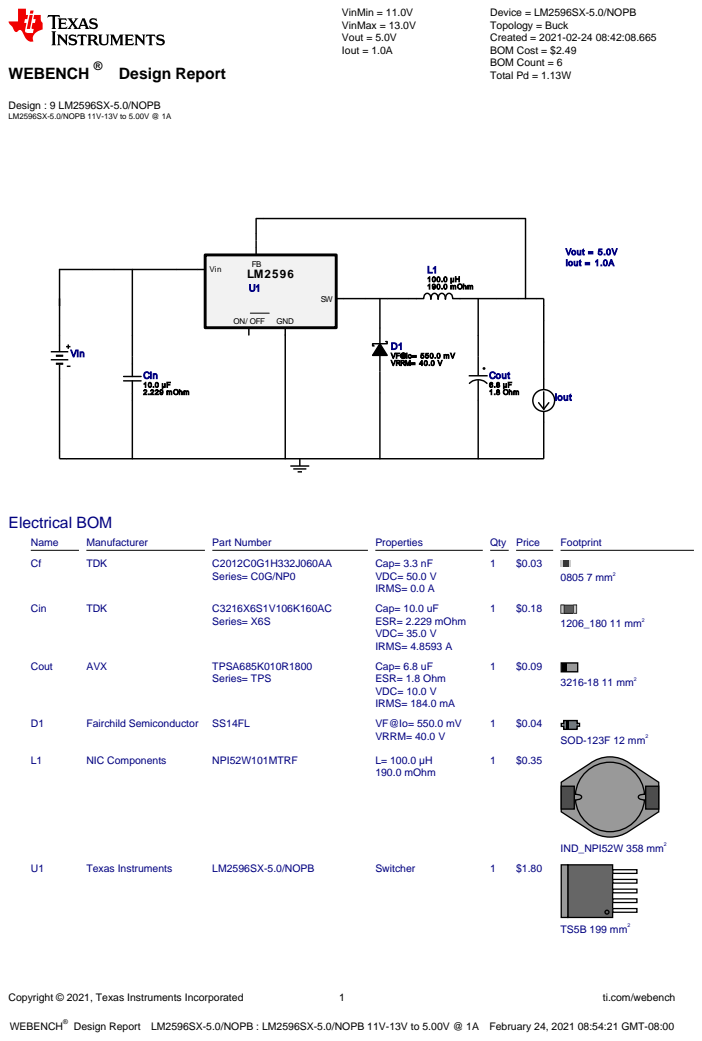
[picture p48: page 1]
Copyright © 2021, Texas Instruments Incorporated; ti.com/webench; WEBENCH®; Design : 9 LM2596SX-5.0/NOPB LM2596SX-5.0/NOPB 11V-13V to 5.00V @ 1A; VinMin = 11.0V VinMax = 13.0V Vout = 5.0V Iout = 1.0A; Device = LM2596SX-5.0/NOPB Topology = Buck Created = 2021-02-24 08:42:08.665 BOM Cost = $2.49 BOM Count = 6 Total Pd = 1.13W; Cin 10.0 µF 2.229 mOhm; Cout 6.8 µF 1.8 Ohm; D1 VF@Io= 550.0 mV VRRM= 40.0 V; L1 100.0 µH 190.0 mOhm; LM2596 Vin; ON/ OFF; GND; Vout = 5.0V Iout = 1.0A; Vin; Iout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

Design Report LM2596SX-5.0/NOPB : LM2596SX-5.0/NOPB 11V-13V to 5.00V @ 1A February 24, 2021 08:54:21 GMT-08:00

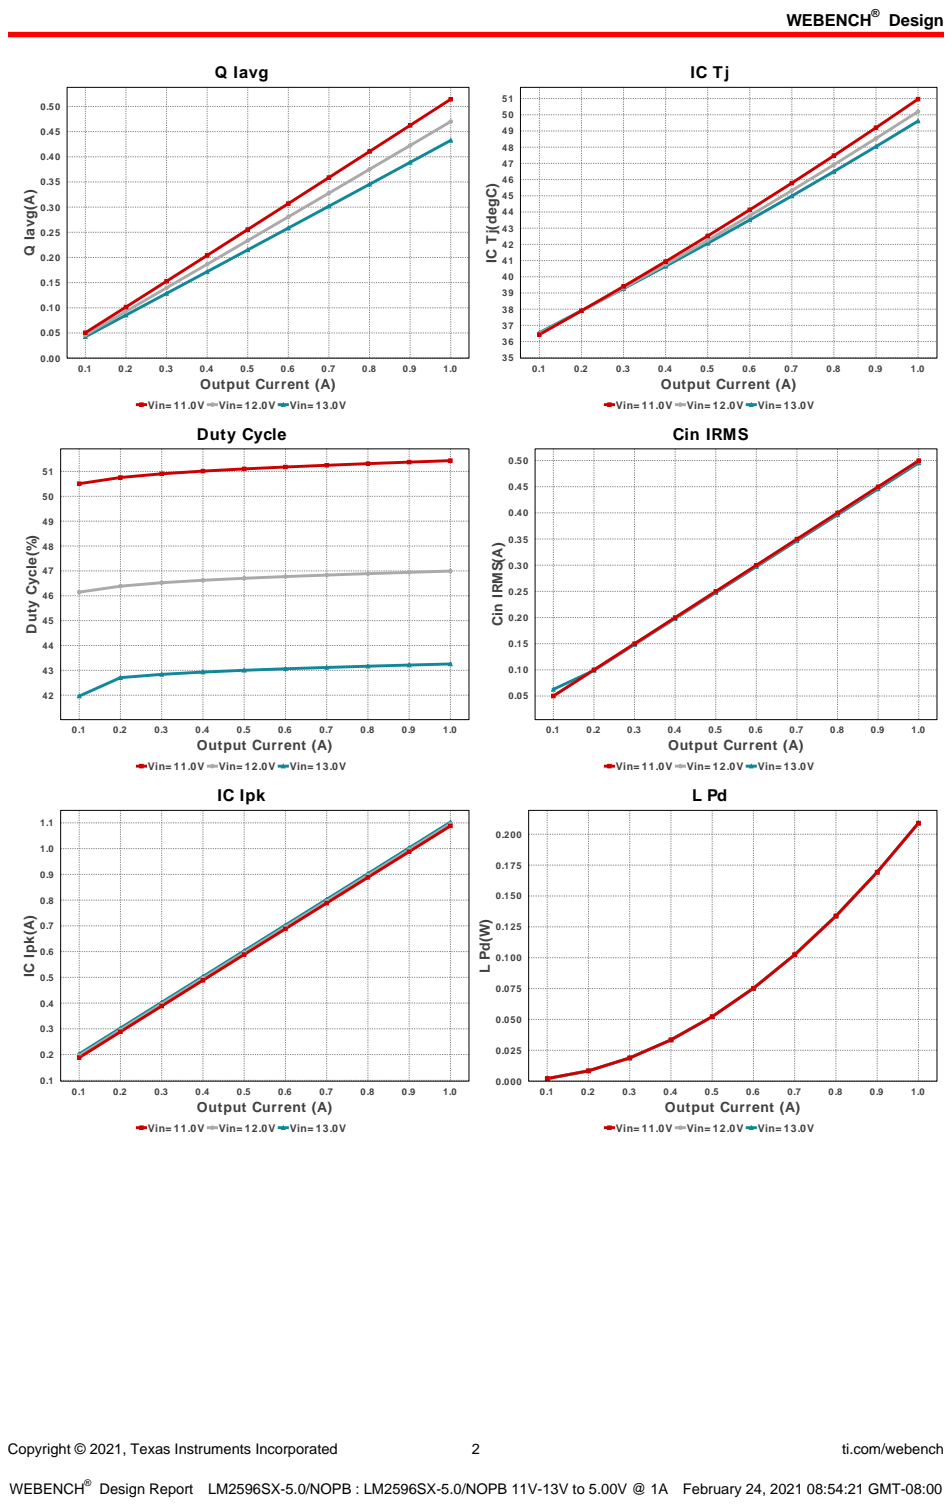
[picture p49: page 2]
Design; Copyright © 2021, Texas Instruments Incorporated; ti.com/webench; Q Iavg; 1.0 Output Current (A); Q Iavg(A); Duty Cycle(%); Cin IRMS(A); IC Ipk; IC Ipk(A)

IC Tj(degC)

Vin= 11.0V Vin= 12.0V Vin= 13.0V
Duty Cycle

Cin IRMS

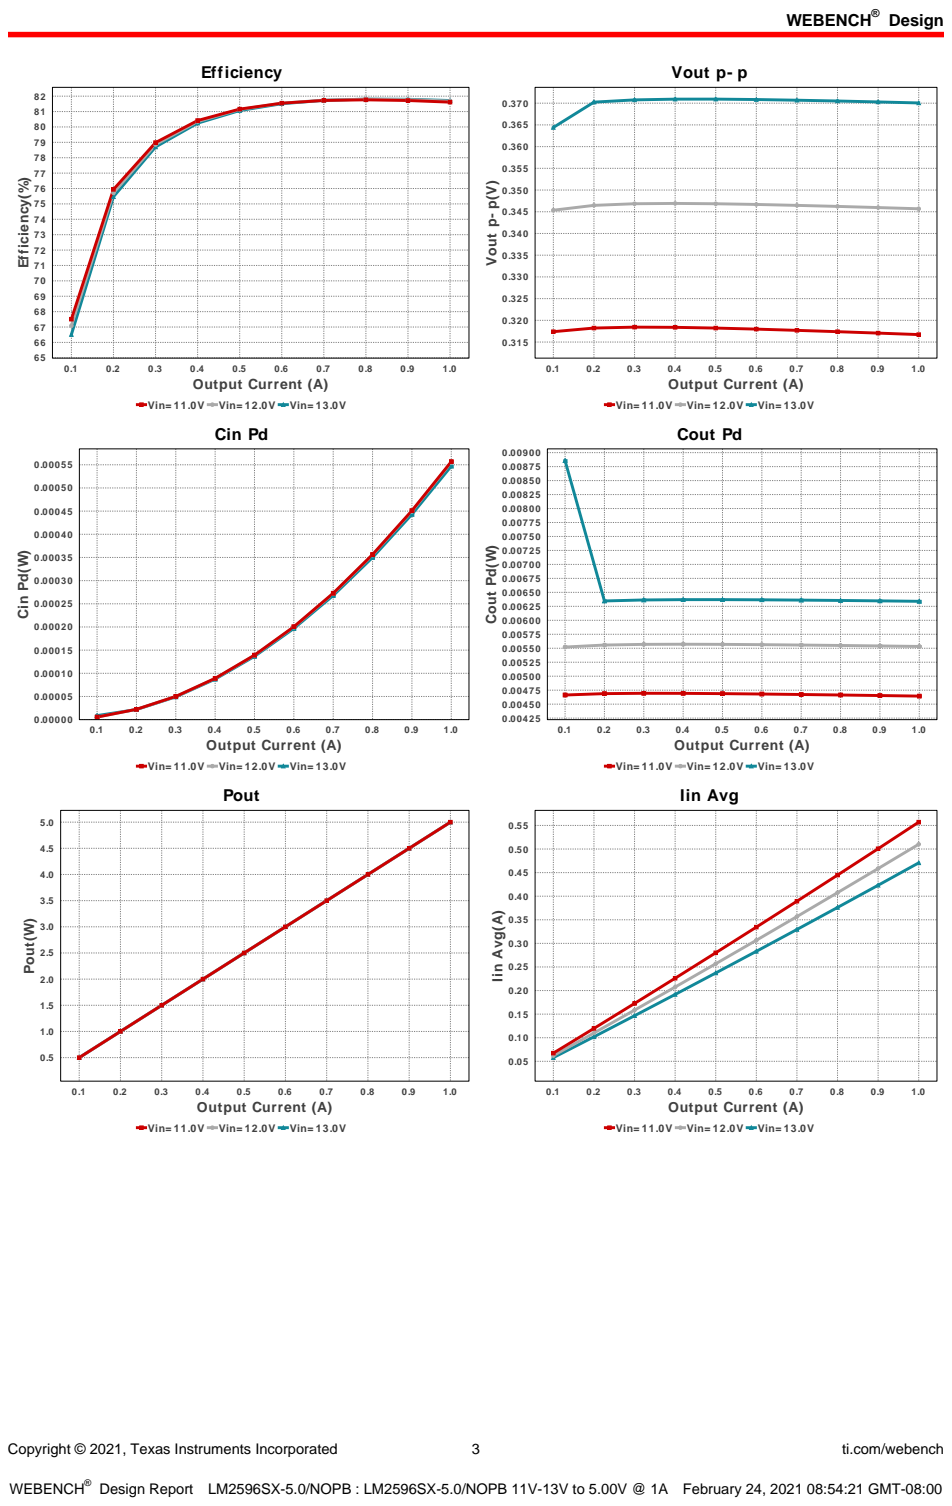
[picture p50: page 3]
Copyright © 2021, Texas Instruments Incorporated; ti.com/webench; Efficiency; 1.0 Output Current (A); Efficiency(%); Vout p- p; Vout p- p(V); Cin Pd; Cin Pd(W); Cout Pd; Cout Pd(W); Pout; Pout(W); Iin Avg; Iin Avg(A)

Vin= 11.0V Vin= 12.0V Vin= 13.0V

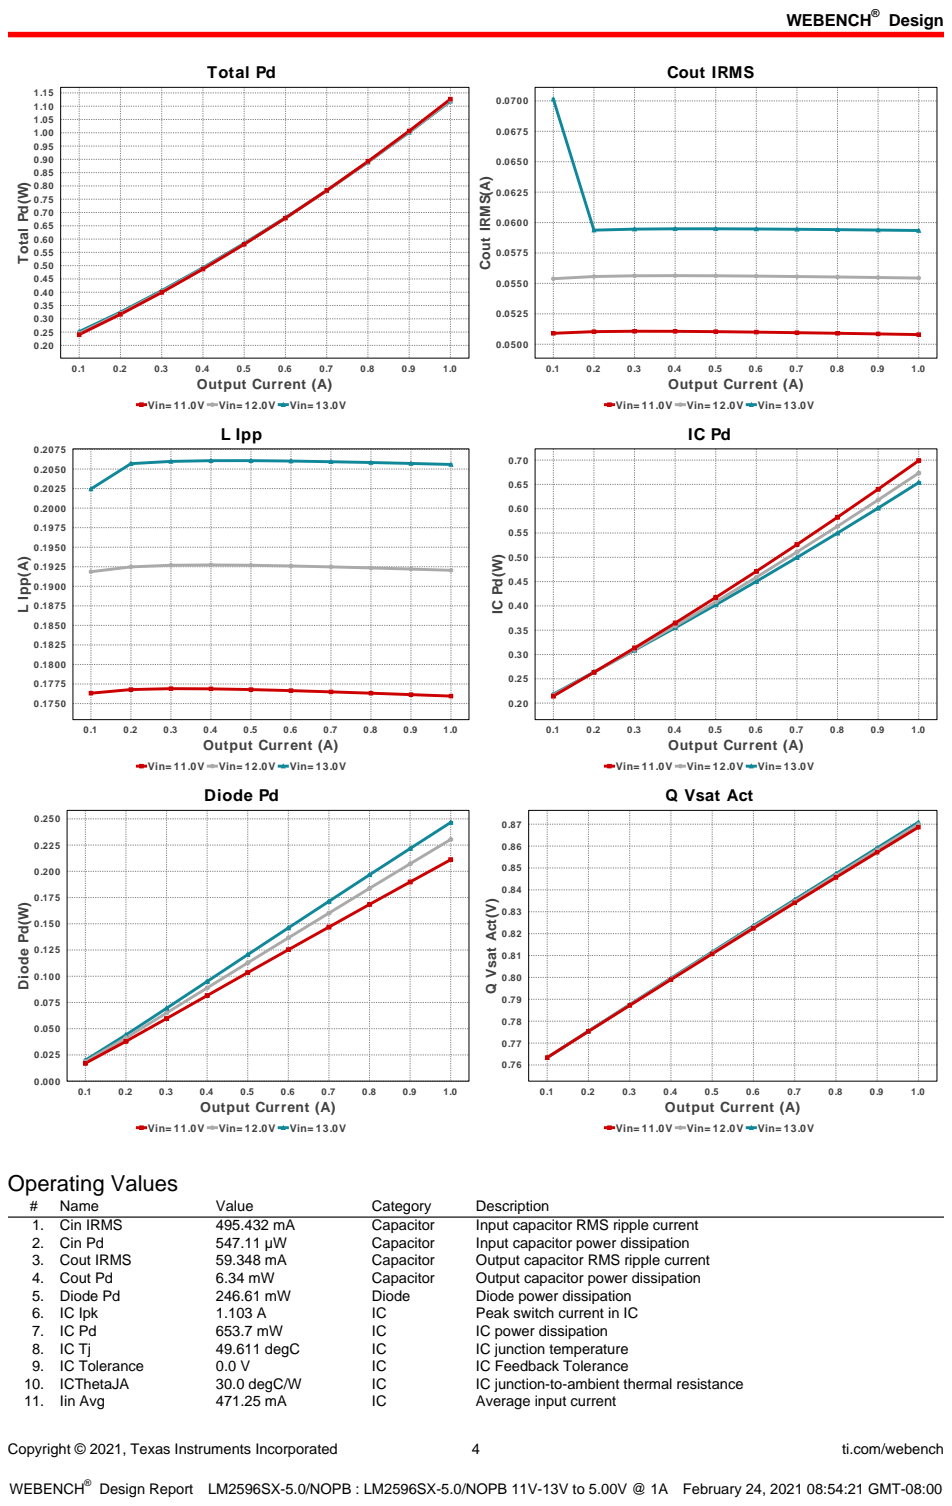
[picture p51: page 4]
Copyright © 2021, Texas Instruments Incorporated; ti.com/webench; Total Pd; 1.0 Output Current (A); Total Pd(W); Cout IRMS; Cout IRMS(A); L Ipp; L Ipp(A); Diode Pd(W); Q Vsat Act(V); Operating Values; Name; Value; Category; Description; 1. Cin IRMS; Capacitor; Input capacitor RMS ripple current; 2. Cin Pd; Input capacitor power dissipation; 3. Cout IRMS; Output capacitor RMS ripple current; 4. Cout Pd; Output capacitor power dissipation; 5. Diode Pd; Diode; Diode power dissipation; 6. IC Ipk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

Vin= 11.0V Vin= 12.0V Vin= 13.0V

Diode Pd

Q Vsat Act

Copyright © 2021, Texas Instruments Incorporated | 5 | ti.com/webench
# | Name | Value | Category | Description

12. L Ipp | 205.59 mA | Inductor | Peak-to-peak inductor ripple current
13. L Pd | 209.0 mW | Inductor | Inductor power dissipation
14. Q Iavg | 432.565 mA | Mosfet | Q Iavg
15. Cin Pd | 547.11 µW | Power | Input capacitor power dissipation
16. Cout Pd | 6.34 mW | Power | Output capacitor power dissipation
17. Diode Pd | 246.61 mW | Power | Diode power dissipation
18. IC Pd | 653.7 mW | Power | IC power dissipation
19. L Pd | 209.0 mW | Power | Inductor power dissipation
20. Total Pd | 1.126 W | Power | Total Power Dissipation
21. BOM Count | 6 | System
| | | Information | Total Design BOM count
22. Duty Cycle | 43.256 % | System
| | | Information | Duty cycle
23. Efficiency | 81.617 % | System
| | | Information | Steady state efficiency
24. FootPrint | 597.0 mm² | System
| | | Information | Total Foot Print Area of BOM components
25. Frequency | 150.0 kHz | System
| | | Information | Switching frequency
26. Iout | 1.0 A | System
| | | Information | Iout operating point
27. Mode | CCM | System
| | | Information | Conduction Mode
28. Pout | 5.0 W | System
| | | Information | Total output power
29. Total BOM | $2.49 | System
| | | Information | Total BOM Cost
30. Vin | 13.0 V | System
| | | Information | Vin operating point
31. Vout p-p | 370.055 mV | System
| | | Information | Peak-to-peak output ripple voltage
32. Q Vsat Act | 870.916 mV | Transistor | Q Vsat

## Design Inputs

Name | Value | Description
Iout | 1.0 | Maximum Output Current
VinMax | 13.0 | Maximum input voltage
VinMin | 11.0 | Minimum input voltage
Vout | 5.0 | Output Voltage
| base_pn | | LM2596 | Base Product Number
source | DC | Input Source Type
Ta | 30.0 | Ambient temperature


Copyright © 2021, Texas Instruments Incorporated | 6 | ti.com/webench

## Assembly

## Component Testing

Some published data on components in datasheets such as Capacitor ESR and Inductor DC resistance is based on conservative values that will guarantee that the components always exceed the specification. For design purposes it is usually better to work with typical values. Since this data is not always available it is a good practice to measure the Capacitance and ESR values of Cin and Cout, and the inductance and DC resistance of L1 before assembly of the board. Any large discrepancies in values should be electrically simulated in WEBENCH to check for instabilities and thermally simulated in WebTHERM to make sure critical temperatures are not exceeded.

## Soldering Component to Board

If board assembly is done in house it is best to tack down one terminal of a component on the board then solder the other terminal. For surface mount parts with large tabs, such as the DPAK, the tab on the back of the package should be pre-tinned with solder, then tacked into place by one of the pins. To solder the tab town to the board place the iron down on the board while resting against the tab, heating both surfaces simultaneously. Apply light pressure to the top of the plastic case until the solder flows around the part and the part is flush with the PCB. If the solder is not flowing around the board you may need a higher wattage iron (generally 25W to 30W is enough).

## Initial Startup of Circuit

It is best to initially power up the board by setting the input supply voltage to the lowest operating input voltage 11.0V and set the input supply's current limit to zero. With the input supply off connect up the input supply to Vin and GND. Connect a digital volt meter and a load if needed to set the minimum Iout of the design from Vout and GND. Turn on the input supply and slowly turn up the current limit on the input supply.
If the voltage starts to rise on the input supply continue increasing the input supply current limit while watching the output voltage. If the current increases on the input supply, but the voltage remains near zero, then there may be a short or a component misplaced on the board. Power down the board and visually inspect for solder bridges and recheck the diode and capacitor polarities. Once the power supply circuit is operational then more extensive testing may include full load testing, transient load and line tests to compare with simulation results.

## Load Testing

The setup is the same as the initial startup, except that an additional digital voltmeter is connected between Vin and GND, a load is connected between Vout and GND and a current meter is connected in series between Vout and the load. The load must be able to handle at least rated output power + 50% ( 7.5 watts for this design). Ideally the load is supplied in the form of a variable load test unit. It can also be done in the form of suitably large power resistors. When using an oscilloscope to measure waveforms on the prototype board, the ground leads of the oscilloscope probes should be as short as possible and the area of the loop formed by the ground lead should be kept to a minimum. This will help reduce ground lead inductance and eliminate EMI noise that is not actually present in the circuit.

## Design Assistance

1. Master key : C119355C87636BCF[v1]
2. LM2596 Product Folder : http://www.ti.com/product/LM2596 : contains the data sheet and other resources.

Copyright © 2021, Texas Instruments Incorporated | 7 | ti.com/webench

Important Notice and Disclaimer

TI provides technical and reliability data (including datasheets), design resources (including reference designs), application or other design advice, web tools, safety information, and other resources AS IS and with all faults, and disclaims all warranties. These resources are intended for skilled developers designing with TI products. You are solely responsible for (1) selecting the appropriate TI products for your application, (2) designing, validating and testing your application, and (3) ensuring your application meets applicable standards, and any other safety, security, or other requirements.

These resources are subject to change without notice. TI grants you permission to use these resources only for development of an application that uses the TI products described in the resource. Other reproduction and display of these resources is prohibited. No license is granted to any other TI intellectual property right or to any third party intellectual property right. TI disclaims responsibility for, and you will fully indemnify TI and its representatives against, any claims, damages, costs, losses, and liabilities arising out of your use of these resources.

Providing these resources does not expand or otherwise alter TI's applicable Terms of Sale or other applicable terms available either on ti.com or provided in conjunction with TI products.
