Akshay1595/Lithium-ion_battery_as_service/HW_design/Libaas_System/Libaas_System.pdf

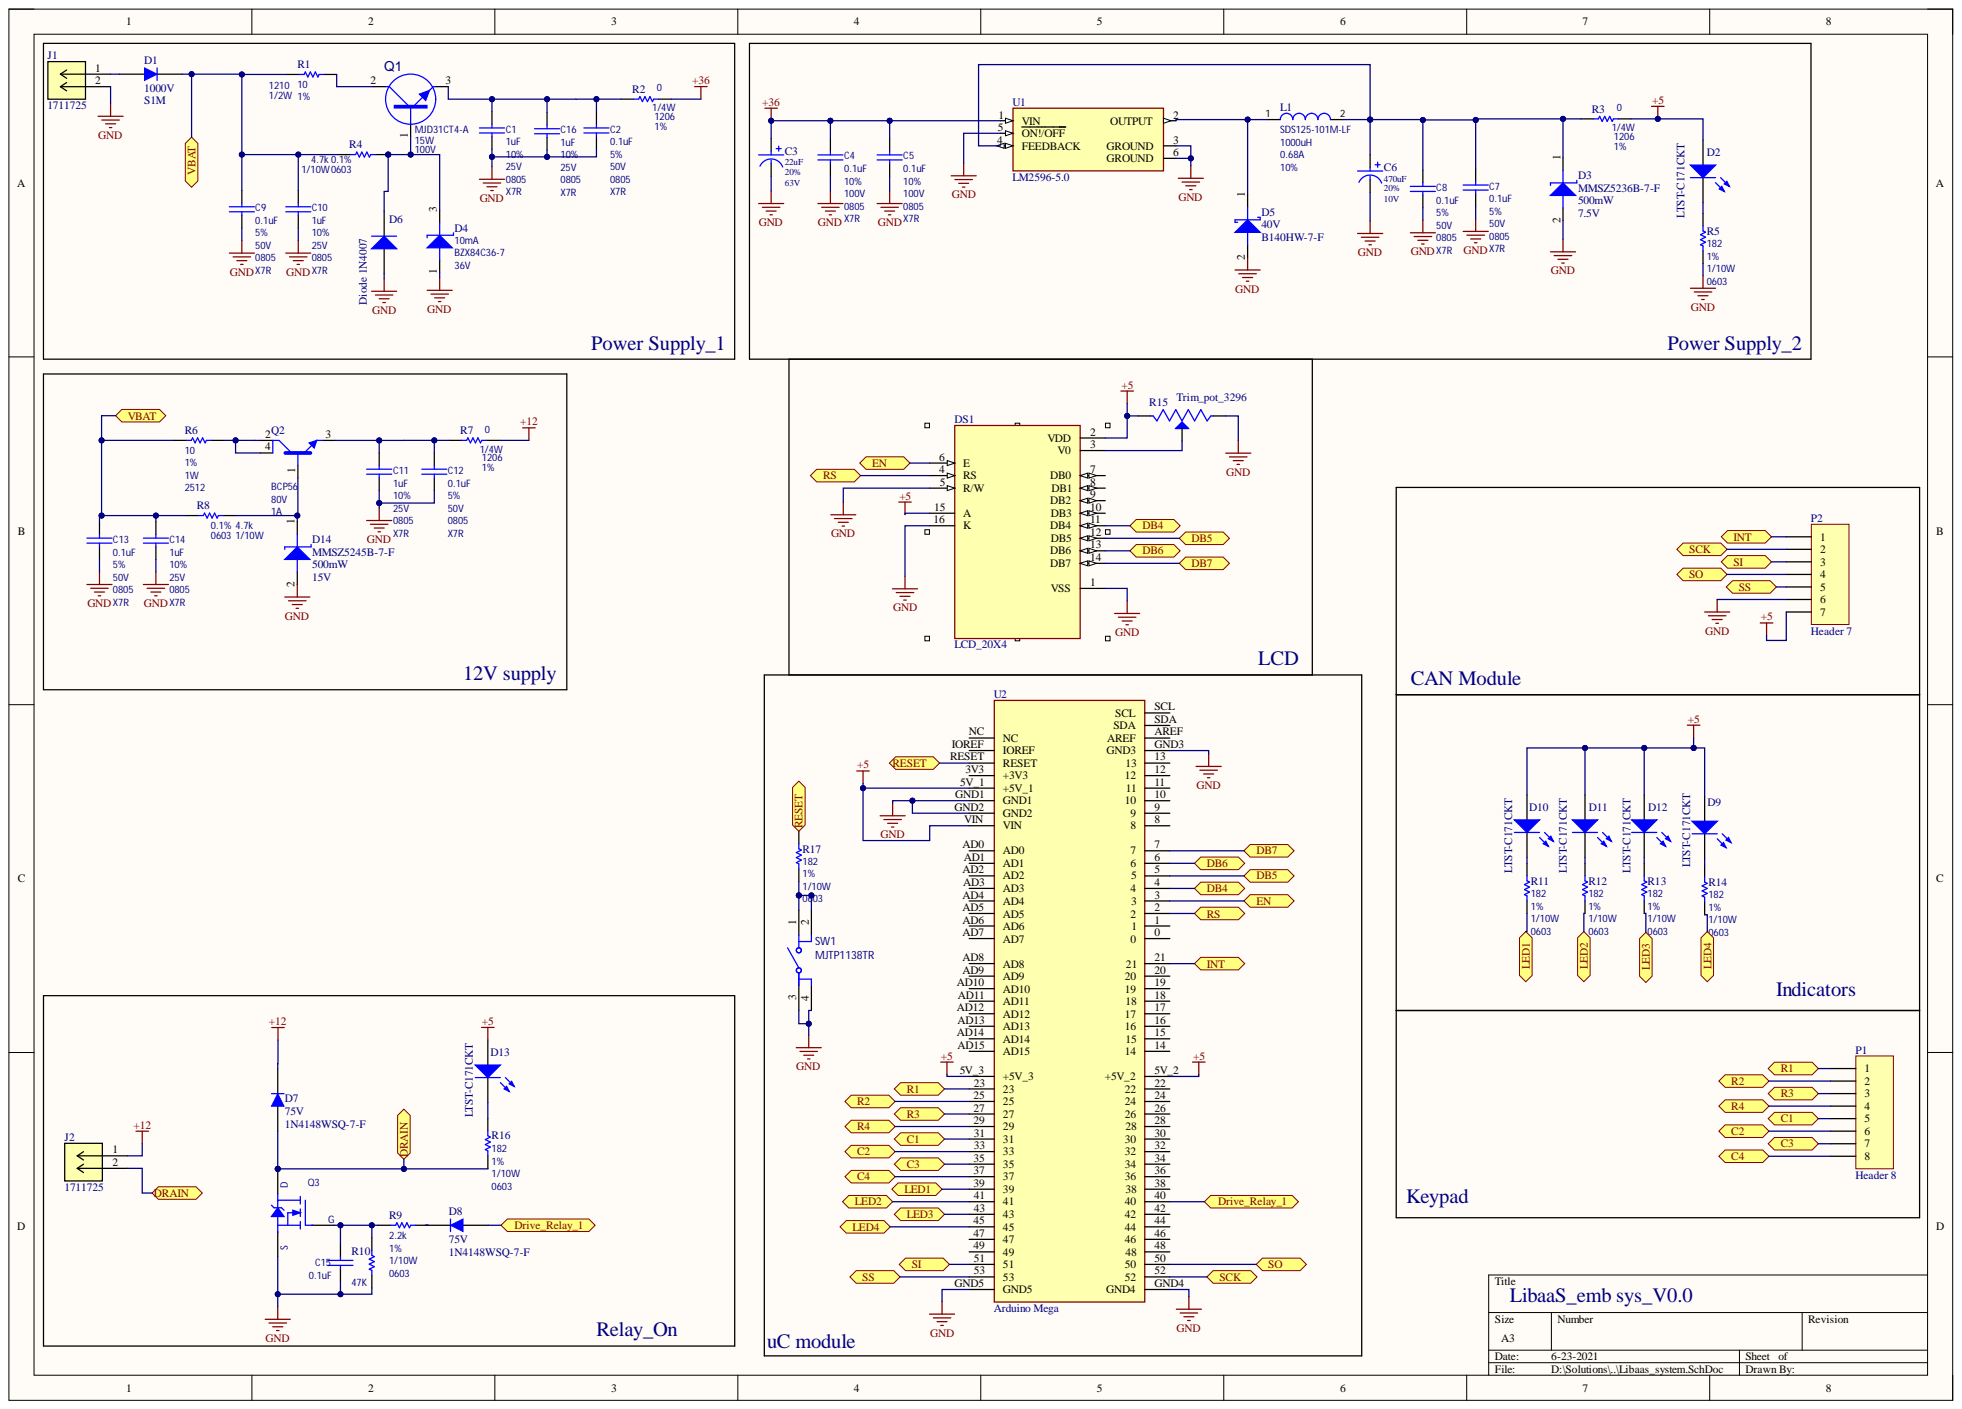
[picture p53: page 1]

ON!/OFF 5
FEEDBACK 4

GROUND | 6

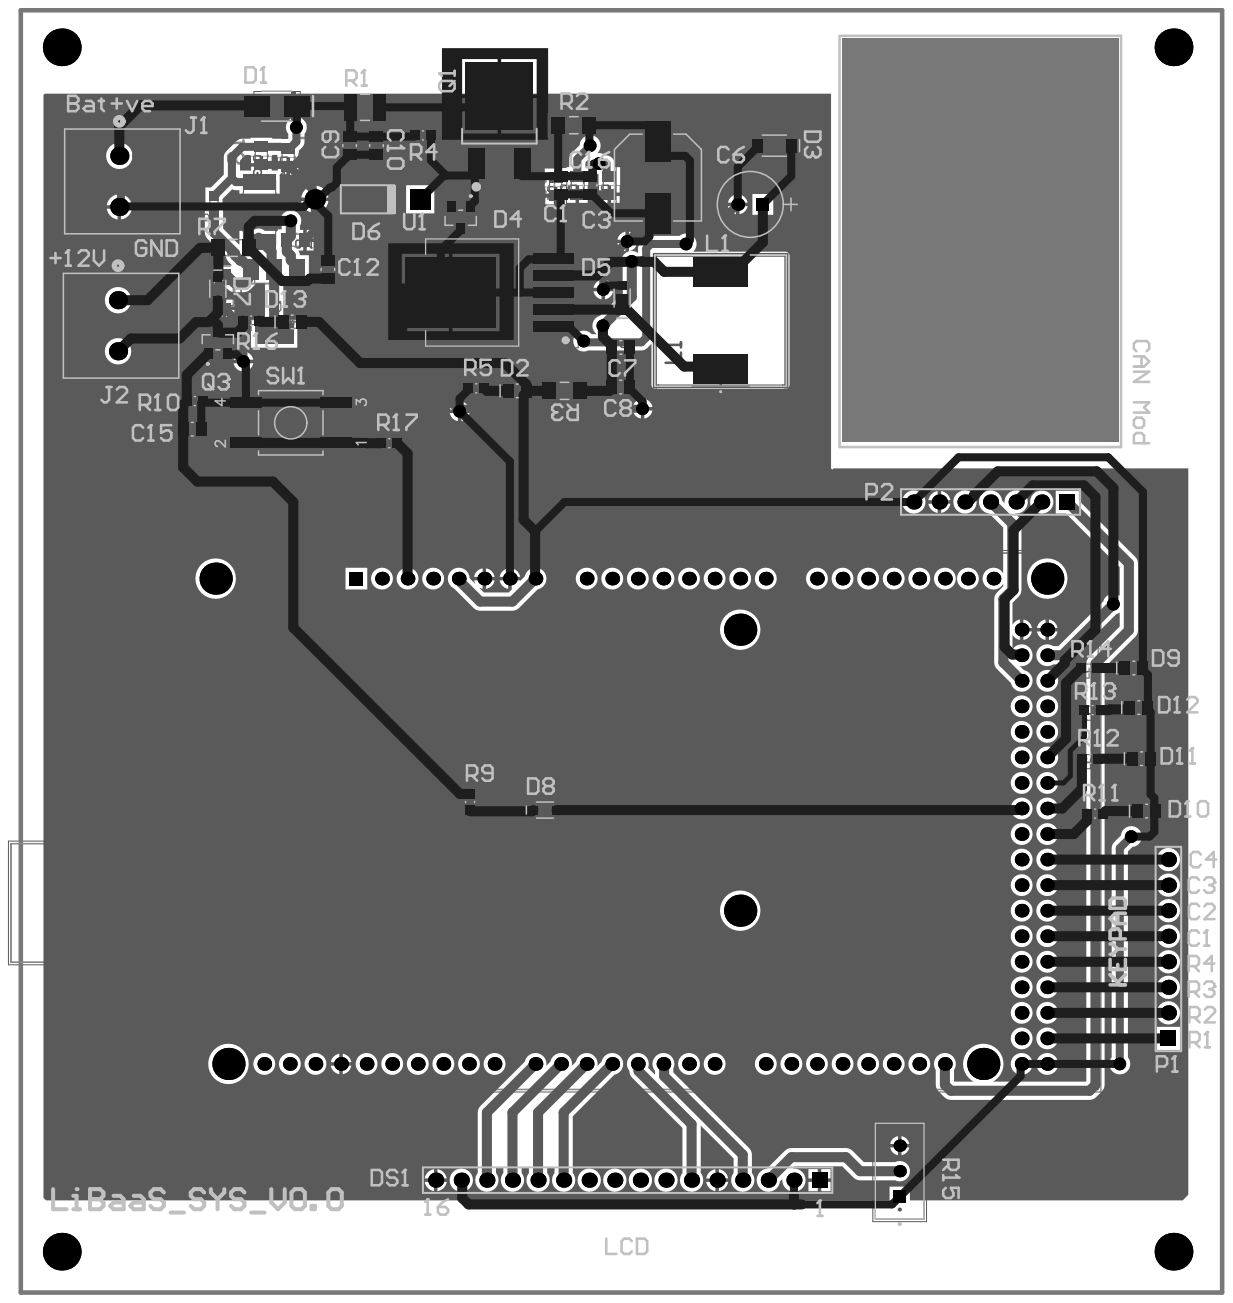
[picture p54: page 2]
