Akshay1595/Lithium-ion_battery_as_service/HW_design/Libaas_System/assy DWG LiBaaS_V0.0.PDF

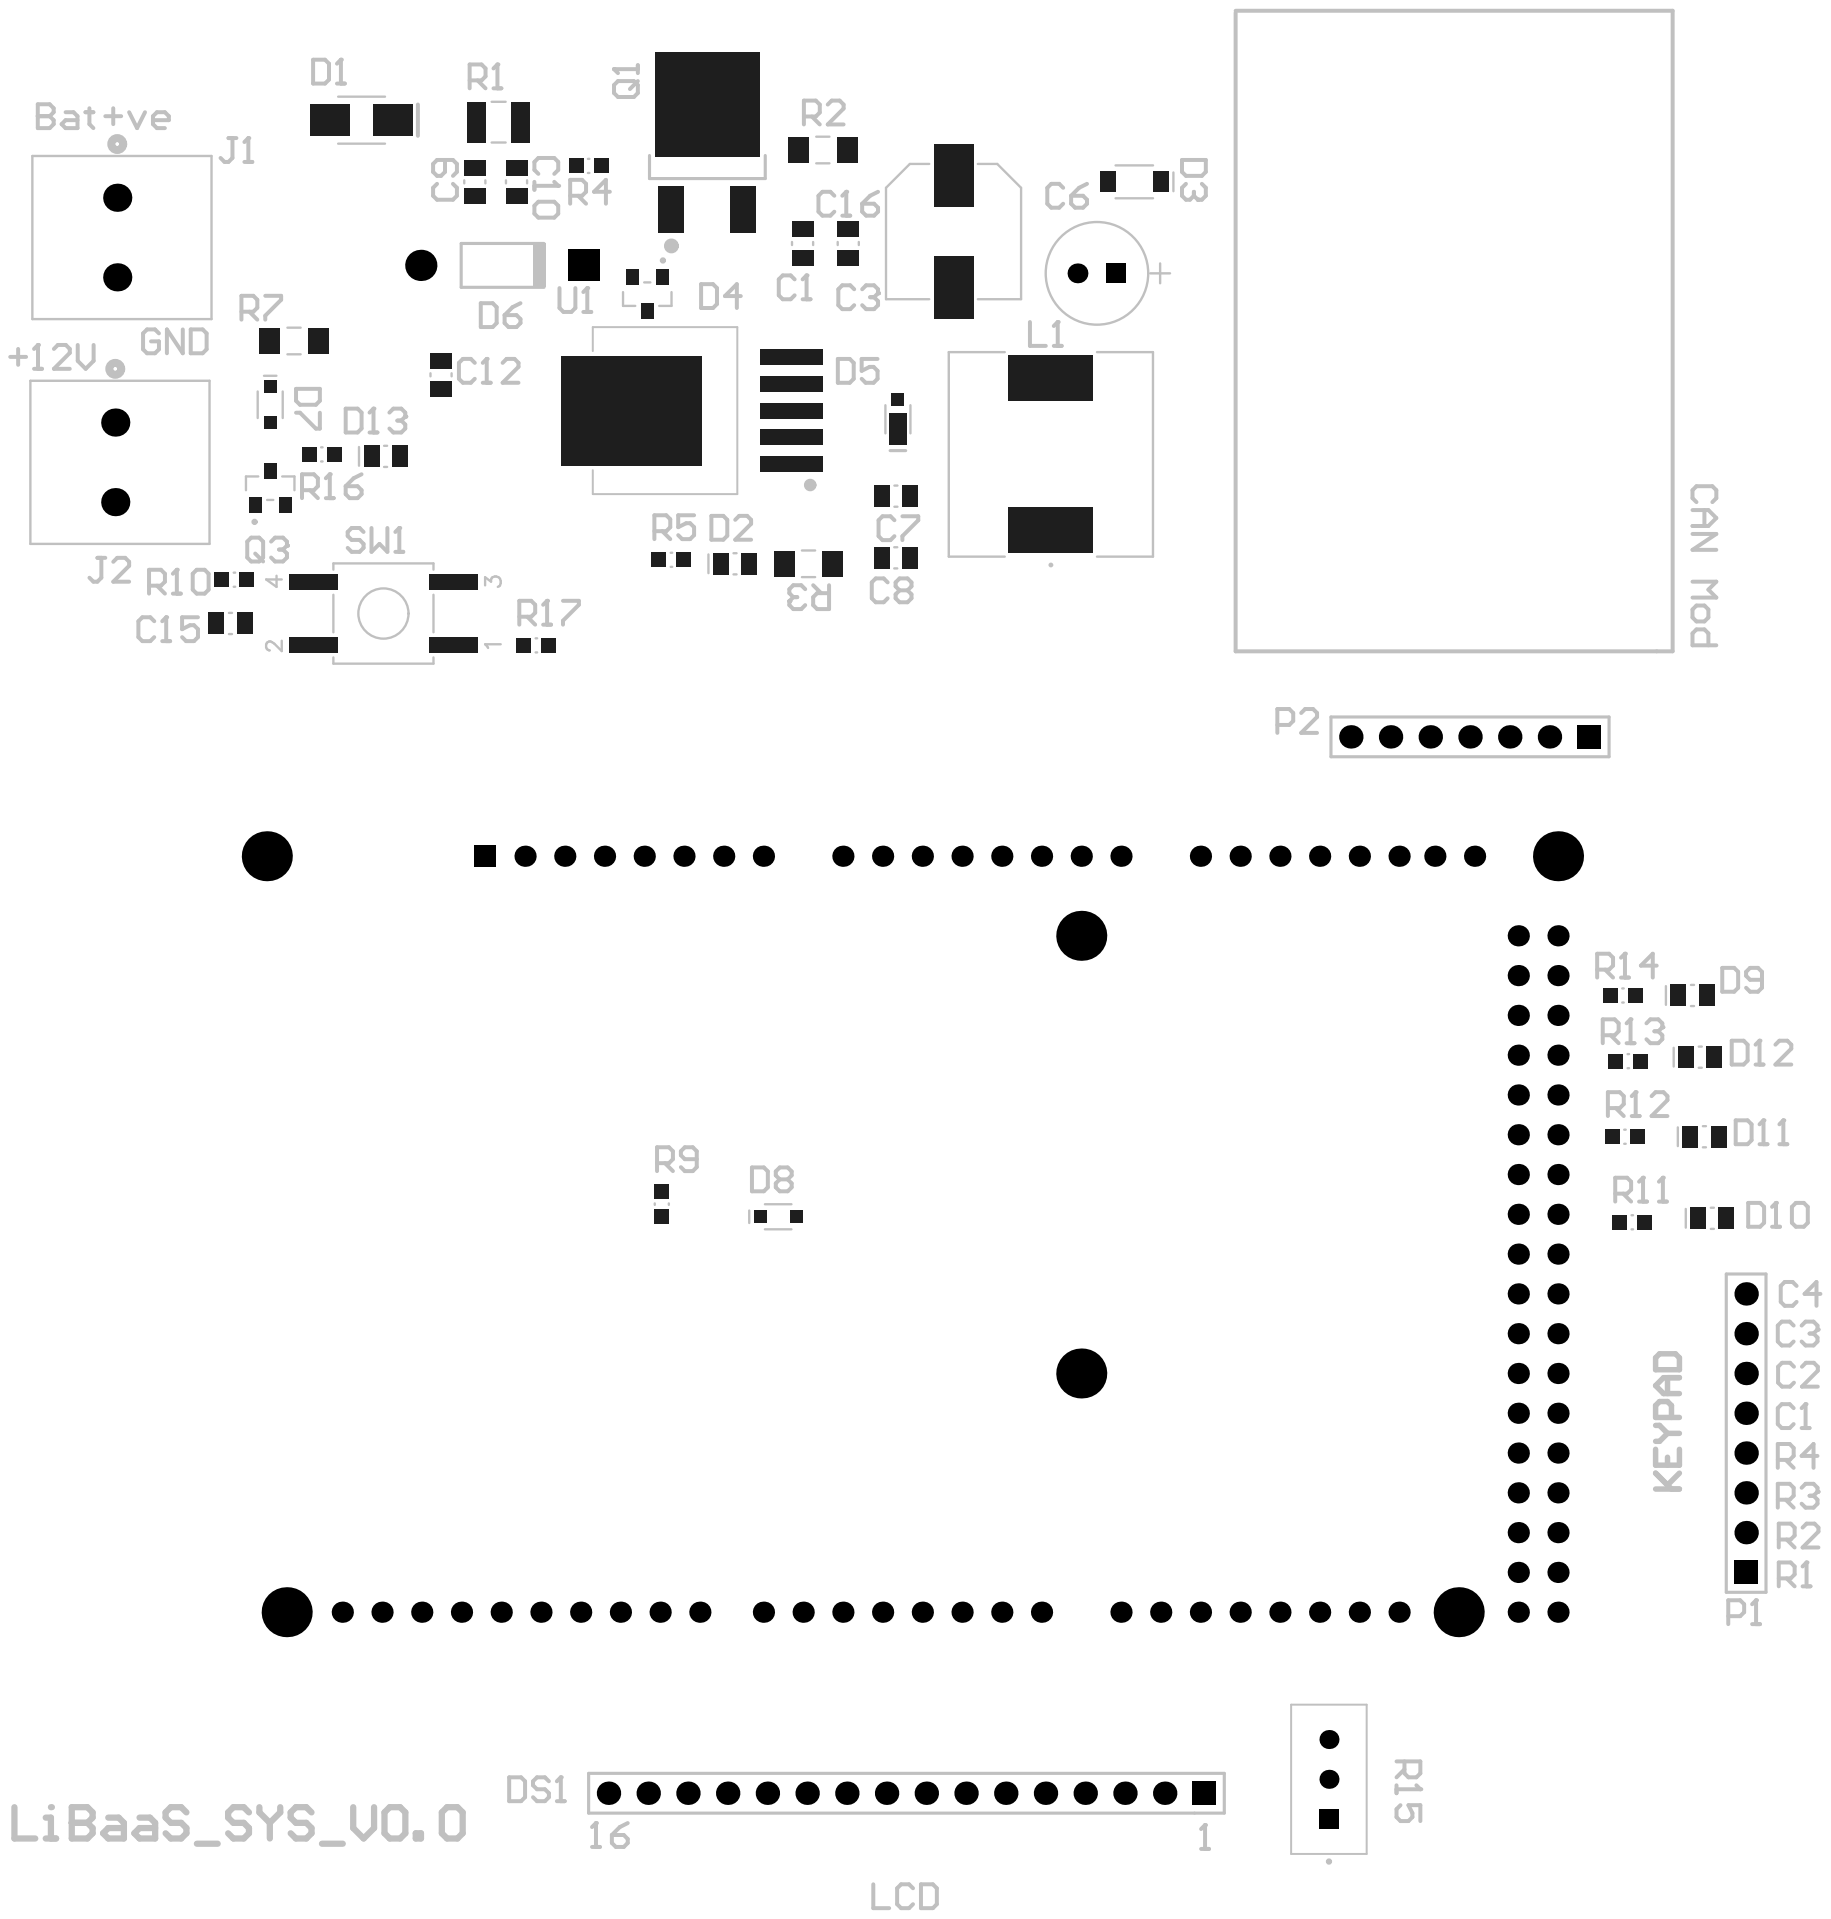
[picture p55: page 1]

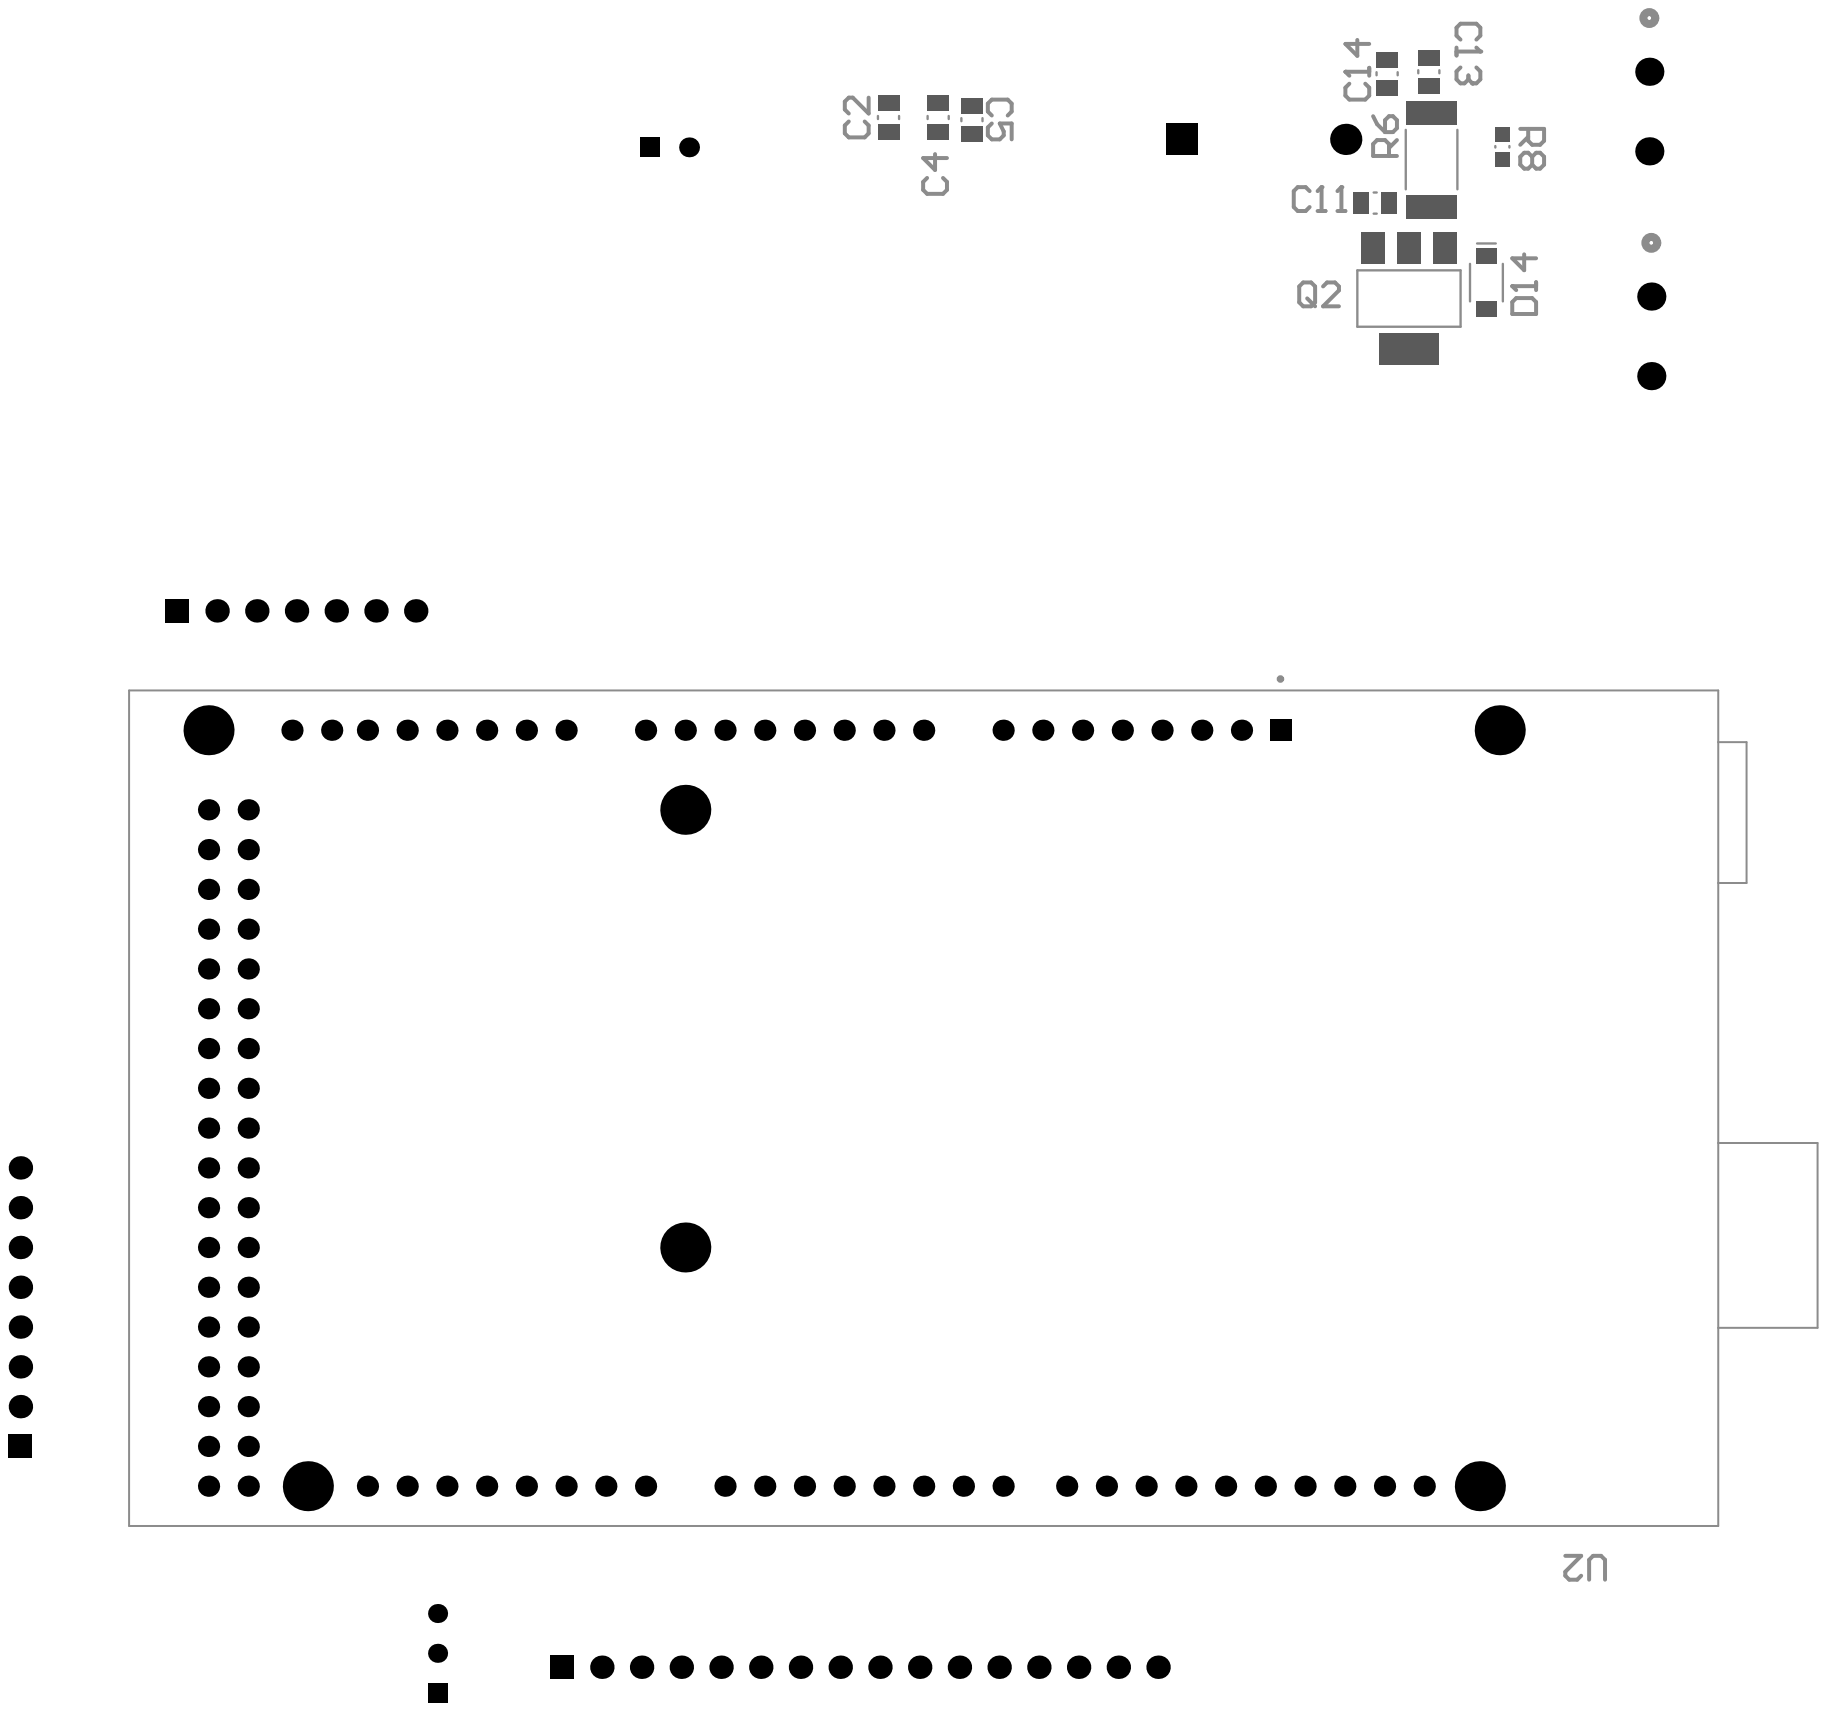
[picture p56: page 2]
