Akshay1595/Lithium-ion_battery_as_service/(list of files, drawings)

Other design files:
HW_design/Libaas_System/Libaas_system.PcbDoc
HW_design/Libaas_System/Libaas_System.PrjPcb
HW_design/Libaas_System/Libaas_system.SchDoc
Proteus_simulation/LiBaAs.pdsprj
