Akshay1595/Lithium-ion_battery_as_service/Code/Li_BaAS/Li_BaAS.ino

#include "inc/my_lcd.h"
#include "inc/my_task.h"
#include "inc/my_can.h"
#include "inc/my_led.h"
#include "inc/my_load.h"
#include "inc/config.h"

void setup() {
  Serial.begin(9600);
  lcd_setup();
  led_setup();
  load_setup();
  task_init();
  can_setup();
}

void loop() {
  // Nothing to do
}
