Akshay1595/Lithium-ion_battery_as_service/Code/Li_BaAS/src/can.cpp

#include "Arduino.h"
#include <SPI.h>
#include <mcp2515.h>
#include "../inc/my_creds.h"
#include "../inc/my_can.h"
#include <Arduino_FreeRTOS.h>
#include "../inc/config.h"
#include "../inc/my_led.h"
#include "../inc/bms.h"
#include "../inc/charger.h"

//#define TEST_CODE

#define DISCHARGE_RATE_MAX      (BATTERY_CAP_IN_WHR)
#define CHARGE_RATE_MAX         (BATTERY_CAP_IN_WHR/10)

#define CS_PIN                  (53)

MCP2515 mcp2515(CS_PIN);

static uint8_t SOC = 100;
static discharge_rate dischargeRate = DISCHARGE_RATE_MAX;
static charge_rate chargeRate = CHARGE_RATE_MAX;
static time_to_full_charge time_remaining = {2, 30};

static bool is_charger_connected = false;

bool can_is_charging(void) {
    return bms_is_charging();
}

static void can_set_charger_connected(void) {
    is_charger_connected = true;
}

static void can_reset_charger_connected(void) {
    is_charger_connected = false;
}

void can_setup(void) {
    mcp2515.reset();
    mcp2515.setBitrate(CAN_500KBPS);//CAN_500KBPS
    mcp2515.setNormalMode();
    debug_log("Can Setup complete!");
}

void can_read_data(void) {
    can_msg_id* id_to_interpret;
    struct can_frame canMsg;
    //Update CAN data
    char msg_id_string[32] = {};
    
    while(1)  {
        
        while(mcp2515.readMessage(&canMsg) != MCP2515::ERROR_OK);
        id_to_interpret = (can_msg_id*)&canMsg.can_id;
        if (id_to_interpret->msg_id == BMS_INFO_MSG_1_MSG_ID) {
            Serial.print("0x");
            Serial.print(id_to_interpret->msg_id, HEX);
            //sprintf(msg_id_string, "0x%X", (uint32_t)id_to_interpret->msg_id);
            //Serial.print(msg_id_string); // print ID
            Serial.print(" "); 
            Serial.print(canMsg.can_dlc, HEX); // print DLC
            Serial.print(" ");
            
            for (int i = 0; i < canMsg.can_dlc; i++)  {  // print the data
                Serial.print(canMsg.data[i],HEX);
                Serial.print(" ");
            }
            Serial.println(" ");
            bms_decrypt_can_msg(&canMsg);
            return;
        }
    }
}

void can_update_data(void *pvParameters) {
    while (true){

        debug_log("Inside the task can_task_to_update_soc");
        
#ifdef TEST_CODE
        // Update SOC
        if (!can_charger_connected()){
            if ( (!creds_is_creds_expired())) {
                if (SOC != 0)
                    SOC = SOC - 1;
                else
                    can_set_charger_connected();
            } 
        } else {
            if (SOC < 100)
                SOC = SOC + 1;
            else
                can_reset_charger_connected();
        }

        // Update Discharge Rate
        {
            if (!can_charger_connected() && !(creds_is_creds_expired())) {
                if( dischargeRate == 0)
                    dischargeRate = (DISCHARGE_RATE_MAX);
                else
                    dischargeRate -= 10;
            }
            else
                dischargeRate = 0;
        }

        //Update charger connection
        {
            if(can_charger_connected()) {
                if (chargeRate <= 0) 
                    chargeRate = CHARGE_RATE_MAX;
                else
                    chargeRate -= 100;
            }
        }
#endif        
        led_toggle_can_data_led();
        can_read_data();
        //debug_log("Returning from this can data update function!\n");
        vTaskDelay(1000 / portTICK_PERIOD_MS);
    }
}

uint8_t can_get_soc(void) {
    #ifndef TEST_CODE
    SOC = bms_get_soc();
    #endif
    return SOC;
}

discharge_rate can_get_discharge_rate(void) {
    #ifndef TEST_CODE
    dischargeRate = bms_get_discharge_rate();
    #endif
    return dischargeRate;
}

charge_rate can_get_charge_rate(void) {
    #ifndef TEST_CODE
    chargeRate = charger_get_charge_rate();
    #endif
    return chargeRate;
}

time_to_full_charge can_get_time_to_charge(void) {
    #ifndef TEST_CODE
    time_remaining = charger_get_time_to_full_charge();
    #endif
    return time_remaining;
}
