Akshay1595/Lithium-ion_battery_as_service/Code/Li_BaAS/inc/charger.h

#ifndef CHARGER_H
#define CHARGER_H

#include "bms.h"

typedef float charge_rate;

// charger global data
typedef struct time_t {
    uint8_t hrs;
    uint8_t mins;
}time_to_full_charge;

typedef struct charge_current_t  {
    float input_vltg;
    float input_current;    
    time_to_full_charge full_chrge_time;
}charger_data;

//---------------------------------------------------------------------------------//
/* Charger Information Message */
#define CHARGER_MSG_ID              (0x18FF50E5)

// function
extern charger_data charger_update_data(bms_data bms_values);
extern time_to_full_charge charger_get_time_to_full_charge(void);
extern batt_i charger_get_charging_current(void);
extern batt_v charger_get_charging_voltage(void);
extern charge_rate charger_get_charge_rate(void);
#endif // CHARGER_H
