Akshay1595/Lithium-ion_battery_as_service/Code/Li_BaAS/src/my_task.cpp

#include "Arduino.h"
#include <Arduino_FreeRTOS.h>
#include "../inc/my_task.h"
#include "../inc/my_keypad.h"
#include "../inc/my_lcd.h"
#include "../inc/my_gui.h"
#include "../inc/my_can.h"
#include "../inc/my_creds.h"
#include "../inc/config.h"

#define PRIORITY_HIGH       (2)
#define PRIORITY_MED        (1)
#define PRIORITY_LOW        (0)

static bool add_key_pressed = false;
TaskHandle_t handle_for_task_to_accept_creds_from_user;

void task_to_check_if_add_key_pressed(void *pvParameters) {
  while (true)
  {
    //debug_log("Inside task task_to_check_if_add_key_pressed");
    if (keypad_is_add_credits_pressed() == true) {
        debug_log("ADD_KEY is pressed\n");
        add_key_pressed = true;
        //delay(50);
        vTaskResume(handle_for_task_to_accept_creds_from_user);
    }
    vTaskDelay(100 / portTICK_PERIOD_MS);
  }  
}

void task_to_accept_creds_from_user(void *pvParameters) {
    //suspend the task initially
    vTaskSuspend(handle_for_task_to_accept_creds_from_user);
    
    while (true) {
      debug_log("### Inside task task_to_accept_creds_from_user");
      debug_log("Resumed Suspended Task!");
      if (add_key_pressed == true)  {
        debug_log("Seems ADD_KEY is pressed! Need to accept user credits");
        creds_get_credits_from_user();
        debug_log("Came back from accepting The credits!\n");
        add_key_pressed = false;
        debug_log("Suspending task again!");
        vTaskSuspend(handle_for_task_to_accept_creds_from_user);
      }
    }
}

void task_init(void) {
  
  xTaskCreate(task_to_accept_creds_from_user, "TASK_TO_ACCEPT_CREDS_FROM_USER", 1024, NULL, (PRIORITY_HIGH+1), &handle_for_task_to_accept_creds_from_user);

  xTaskCreate(gui_update_based_on_mode, "TASK_TO_PRINT_LCD_DATA", 1024, NULL, (PRIORITY_MED+1), NULL); 
  
  xTaskCreate(task_to_check_if_add_key_pressed, "TASK_TO_CHECK_IF_ADD_KEY_PRESSED", 1024, NULL, (PRIORITY_LOW+1), NULL);

  xTaskCreate(can_update_data, "TASK_TO_UPDATE_DATA", 1024, NULL, (PRIORITY_LOW), NULL); 

  debug_log("Task Init done!");
}
