Akshay1595/Lithium-ion_battery_as_service/Code/Li_BaAS/src/gui.cpp

#include <math.h>
#include "Arduino.h"
#include "../inc/my_gui.h"
#include "../inc/my_lcd.h"
#include "../inc/my_can.h"
#include "../inc/my_creds.h"
#include <Arduino_FreeRTOS.h>
#include "../inc/my_led.h"
#include "../inc/config.h"

static void gui_watt_conversions(uint32_t watts, char *buff) {
    char string_c[20] = {};
    if (watts < 1000) {
      sprintf(buff, "%uWH",watts);
    } else if (watts < 1000000) {
      dtostrf(((float)watts/1000),5,2,string_c);
      sprintf(buff, "%sKWH",string_c);     
    }
    else {
      dtostrf(((float)watts/1000000),5,2,string_c);
      sprintf(buff, "%sMWH",string_c);      
    }
}

static void get_credits_to_watt_in_string(uint64_t credits, char *buff) {
    char new_string[128] = {};
#ifndef CREDS_IN_RS
    gui_watt_conversions(credits,buff);
    sprintf(new_string, "Creds %s",buff);
    strcpy(buff, new_string);
#else
    sprintf(buff,"Credits: %lu Rs",credits);
#endif
}

static uint32_t my_pow(uint8_t number,uint8_t index) {
    uint32_t final = 1;
    while (index) {
        final *= number;
        index--;
    }
    return final;
}

static inline void get_credits_to_string(char* buff) {
    get_credits_to_watt_in_string(creds_get_available_credits(),buff);
}

static void get_soc_to_string(char *buff) {
    uint8_t soc = can_get_soc();
    sprintf(buff, "Battery: %d %%",soc);
}

char *dtostrf (float val, signed char width, unsigned char prec, char *sout) {
  uint16_t iPart = (uint16_t)val;
  uint32_t dPart = (uint32_t)((float)my_pow(10,2) * (val - (float)iPart));
  sprintf(sout, "%d.%d", iPart, dPart);  
  return sout;
}

static void gui_print_lcd(char lcd_string[4][20]) {
    lcd_clear();
    lcd_setCursor(0, 0);
    lcd_print_str(lcd_string[0]);
    lcd_setCursor(1, 0);
    lcd_print_str(lcd_string[1]);
    lcd_setCursor(2, 0);
    lcd_print_str(lcd_string[2]);
    lcd_setCursor(3, 0);
    lcd_print_str(lcd_string[3]);

}

//---------------------------------------------Default Mode--------------------------------------//
static void gui_discharge_rate_str_conversion(char *buf, discharge_rate dischargeRate) {
    dtostrf(dischargeRate, 5, 2, buf);
    strcat(buf, " W");
}

void gui_update_for_default_mode(void) {

    char lcd_string[4][20] = {};
    get_credits_to_string(lcd_string[0]);
    get_soc_to_string(lcd_string[2]);

    discharge_rate dis_rate = can_get_discharge_rate();
    char string_c[32] = {}; gui_discharge_rate_str_conversion(string_c, dis_rate);
    sprintf(lcd_string[1], "Dischrge: %s", string_c);

    gui_print_lcd(lcd_string);
}

//---------------------------------------------Charging Mode------------------------------------//
static void gui_charge_rate_str_conversion(char *buf, charge_rate chargeRate) {
    dtostrf(chargeRate, 5, 2, buf);
    strcat(buf, " W");
}

void gui_update_for_charging_mode(void) {
    char lcd_string[4][20] = {};
    get_soc_to_string(lcd_string[3]);
    
    time_to_full_charge time_remaining = can_get_time_to_charge();
    charge_rate chargeRate = can_get_charge_rate();
    char string_c[32] = {}; gui_charge_rate_str_conversion(string_c, chargeRate);

    sprintf(lcd_string[0], "%dHr %dMin to charge",time_remaining.hrs,time_remaining.mins);
    sprintf(lcd_string[1], "Chrging @ %s",string_c);
    
    get_credits_to_string(lcd_string[2]);
    
    gui_print_lcd(lcd_string);

    debug_log("------LCD Print------");
    debug_log(lcd_string[0]);
    debug_log(lcd_string[1]);
    debug_log(lcd_string[2]);

}

//-------------------------------------- Creds Expired Mode --------------------------------------//

void gui_update_for_creds_expired_mode(void) {

    char lcd_string[4][20] = {};
    get_soc_to_string(lcd_string[3]);
    get_credits_to_string(lcd_string[0]);
    strcpy(lcd_string[1],"Credits Expired");
    strcpy(lcd_string[2],"Add Credits");

    gui_print_lcd(lcd_string);
}

//-------------------------------------- Add Creds Mode --------------------------------------//

void gui_update_for_add_creds_mode(void) {
    char lcd_string[4][20] = {};
    get_credits_to_string(lcd_string[3]);
    strcpy(lcd_string[0],"Enter Credits and");
    strcpy(lcd_string[1],"press Done");
    gui_print_lcd(lcd_string);
}

void gui_update_for_add_creds_mode_success(uint32_t credits_added) {
    char lcd_string[4][20] = {};
    strcpy(lcd_string[0],"Success");
    strcpy(lcd_string[1],"Credits added");

    get_credits_to_watt_in_string(credits_added,lcd_string[2]);

    get_credits_to_string(lcd_string[3]);
    gui_print_lcd(lcd_string);
}

void gui_update_for_add_creds_mode_failure(void) {
    char lcd_string[4][20] = {};

    strcpy(lcd_string[0],"Failure");
    strcpy(lcd_string[1],"Press Back and");
    strcpy(lcd_string[2],"Re-enter credits");

    get_credits_to_string(lcd_string[3]);
    gui_print_lcd(lcd_string);
}


void gui_update_based_on_mode(void *vParameters) {
    while (true)
    {
        debug_log("--- Inside task task_to_print_lcd_data");
        // Update credits first
        creds_update_creds_based_on_soc();

        //Update data after that
        if(can_is_charging()) {
            gui_update_for_charging_mode();
            led_clear_charging_indicator();
        } else if(creds_is_creds_expired()) {
            gui_update_for_creds_expired_mode();
            led_set_charging_indicator();
        } else {
            gui_update_for_default_mode();
            led_set_charging_indicator();
        }   

        // Update display after every 1 second
        led_toggle_gui_task_led();
        vTaskDelay(1000 / portTICK_PERIOD_MS);
    }
}
