Akshay1595/Lithium-ion_battery_as_service/(commit log)

2020-12-05 First commit to project This code can accept the argument from user for credits and print soc and credits both on the screen
2021-01-19 Adding All Necessary Documents for this project 1) FlowChart and State Diagram of LiBaAS 2) Project block Diagram 3) Requirement Document 4) Planning Sheet
    [LiBaAs.pdsprj, Planing_Sheet_for_LiBaAs.xlsx]
2021-01-20 Moved to doc folder
    [Planing_Sheet_for_LiBaAs.xlsx]
2021-01-22 Updated code for Representation of saved credits value into KW/ MW/ Watts And One bug related to reading data from memory updated
    [gui.cpp, memory.cpp]
2021-01-24 Added 1) Bills 2) Expenses Details sheet Modified 1) Planning sheet for Hrs Planned changed to 3 hrs per day
    [Expenses Details.xlsx, Planing_Sheet_for_LiBaAs.xlsx]
2021-01-24 Updated Expenses sheet for 1) Bill Links added 2) Bill for CAN Analyzer
    [Expenses Details.xlsx]
2021-01-25 Added Mega Pin Out
2021-01-25 Arduino schematic Doc
2021-01-25 Schematic update
    [Libaas_system.SchDoc]
2021-01-25 Schematic change
    [Libaas_system.SchDoc]
2021-01-30 Schematic change & BOM update
    [Libaas_System.PrjPcb, Libaas_System.xlsx, Libaas_System_1.xlsx, Libaas_system.SchDoc]
2021-02-08 Added Invoice for battery pack and BMS before order
2021-02-08 Updated Expenses Details with new sheet added with individual expenses and few updates
    [Expenses Details.xlsx]
2021-02-08 updated BOM
    [Libaas_System_1.xlsx]
2021-02-09 1] Added Requirement sign-off document 2] Updated Requirement document to revision 0.0.3 3] Updated planning sheet with status today 4] Updated Expenses sheet with addition of one more sheet to track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
    [Expenses Details.xlsx, Planing_Sheet_for_LiBaAs.xlsx]
2021-02-10 Updated sheet
    [Expenses Details.xlsx]
2021-02-10 Updated schematic
    [Libaas_System.PrjPcb, Libaas_System_1.xlsx, Libaas_system.SchDoc]
2021-02-10 PCB & BOM
    [Libaas_System_090221.xlsx, Libaas_System_090221_RajivEl.xlsx, Libaas_system.PcbDoc]
2021-02-11 Updated schematic & layout
    [Libaas_System.PrjPcb, Libaas_system.PcbDoc, Libaas_system.SchDoc]
2021-02-18 Updated Code with following details: 1] Added Library for Load 2] Added Library for LED 3] Added Library for mcp2515 library 4] Updated connections as per new configuration
2021-02-20 Added Datasheet for CAN based BMS
2021-02-23 inventory update
    [Libaas_System_090221_RajivEl.xlsx]
2021-02-23 PCB update
    [Libaas_system.PcbDoc]
2021-02-28 updated hardware
    [Libaas_System.PrjPcb]
2021-03-08 updated BOM & assembly DWG
    [Libaas_System.PrjPcb, Libaas_System_090221.xlsx, Libaas_system.PcbDoc]
2021-03-09 Load for battery
2021-03-13 Expense sheet updated
    [Expenses Details.xlsx]
2021-03-26 Component assy check doc
    [LiBaaS_component assy check.xlsx]
2021-04-17 Adding Bill 11 to the bills Section
    [Expenses Details.xlsx]
2021-04-17 Updated sheet with new bill for burg strip
    [Expenses Details.xlsx]
2021-05-16 Updated expenses
    [Expenses Details.xlsx]
2021-05-17 updated board status
    [LiBaaS_component assy check.xlsx]
2021-06-28 Calculations updated
    [LibaaS calculations.xlsx]
2021-06-28 Log file updated for Sample check!
2021-07-03 Well Tested Code with Additions as below: 1] Modified code for Charging Mode and tested with real time charging scenario 2] Added LED for charging indication 3] Modified code for updating GUI data ba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
2021-07-03 Updated Expense Details with following Expenses: 1] Added Battery pack delivery Dunzo Bill - Akshay 2] Updated Battery pack charger and Bulbs for load box experiment - Akshay
    [Expenses Details.xlsx]
2021-07-14 Added 2 more bills 1] Bill_16 and 2] Bill_17
    [Expenses Details.xlsx]
2021-07-14 Updated Expenses Sheet with 1] Bill_16 and 2] Bill_17
    [Expenses Details.xlsx]
2021-08-04 Adding Demo for 1st prototype
2021-08-04 Adding bills for Expenses while procuring components for 1] load box 2] Heat sink 3] others
    [Expenses Details.xlsx]
2021-08-04 updated hyperlinks for all bills
    [Expenses Details.xlsx]
2021-08-04 updated expense share
    [Expenses Details.xlsx]
2021-08-06 updated expenses which to be shared with sobby
    [Expenses Details.xlsx, Expenses Details_ext.xlsx]
2021-08-14 expense updated
    [Expenses Details_ext.xlsx]
2021-08-17 Updated Timesheet for Customer
    [Planing_Sheet_for_LiBaAs.xlsx]
2021-08-20 Updated Expense Sheet with the bill of 500 Rs for shipment of Load Box Paid by Akshay Godase
    [Expenses Details.xlsx]
2021-08-30 updated expense sheet
    [Expenses Details.xlsx]
2021-11-22 Added apps for BMS that needs to be used. Here ver1 is older app while ver1.4 is newer one provided by SSK
2021-11-24 Added bill_32 of porter transfer of battery pack to Nikhil's place to get it repaired.
2021-11-24 Updated expense sheet: 1] Restructured sheet with new way 2] Updated link for Bill_32
    [Expenses Details.xlsx]
2021-12-03 Updated expense sheet for Bill 34 and 35
    [Expenses Details.xlsx]
2021-12-03 Bill_34 and Bill_35 links updated in the expense sheet
    [Expenses Details.xlsx]
2022-02-15 Added updated Expenses Details with latest change
    Added 2 expenses which we received from Soby
    [Expenses Details.xlsx]
